Lzw655/kicad_custom_lib/3dmodels/Connector_Others/User Library-TER-KF128-2P.STEP

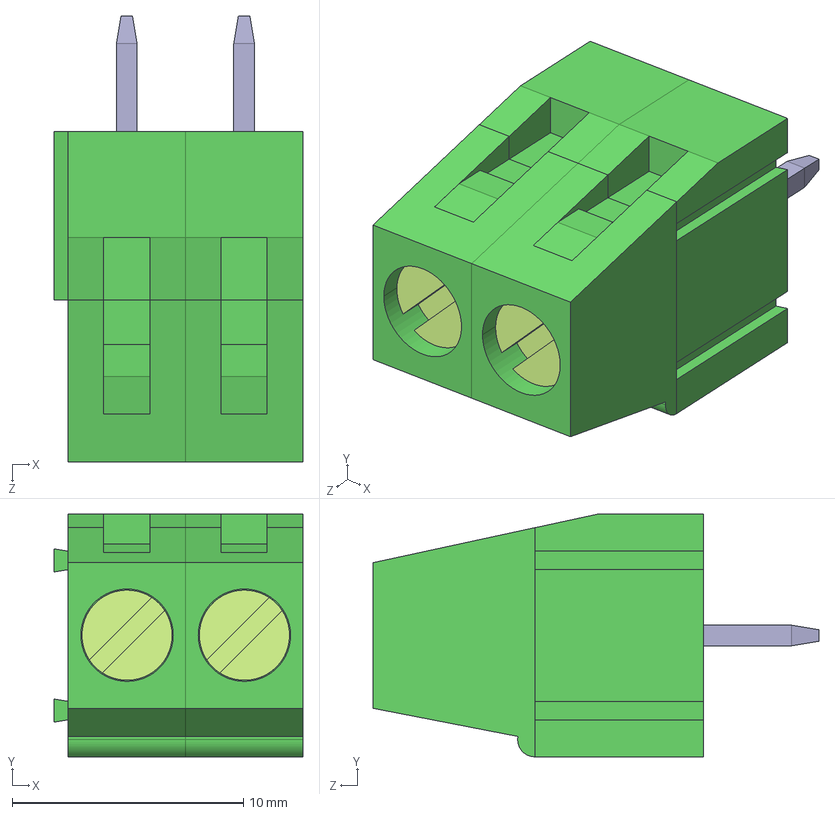
[picture p5: CAD file, 2022-12-03]
3dmodels/Connector_Others/User Library-TER-KF128-2P.STEP
10.8 x 10.5 x 19.3 mm
