Lzw655/kicad_custom_lib/3dmodels/Connector_Power/User Library-A3D-014-00008.STEP

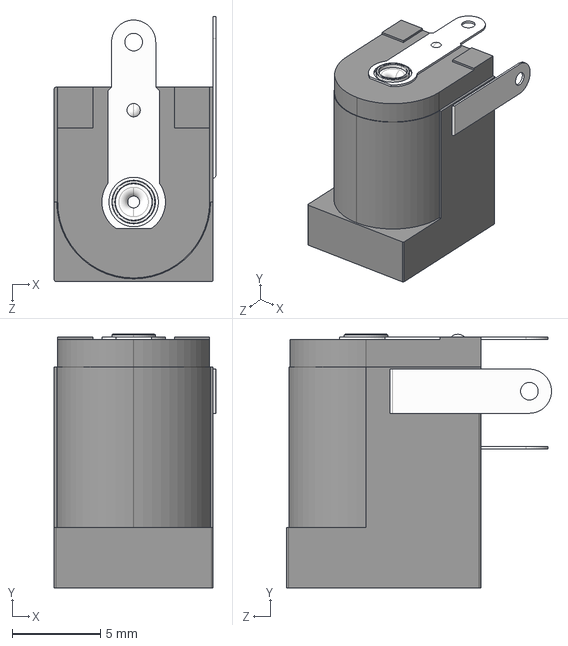
[picture p6: CAD file, 2022-12-03]
3dmodels/Connector_Power/User Library-A3D-014-00008.STEP
9.15 x 14.3 x 15.0 mm
