Lzw655/kicad_custom_lib/3dmodels/Display_7Segment_Module/User Library-IND 3641 RED.STEP

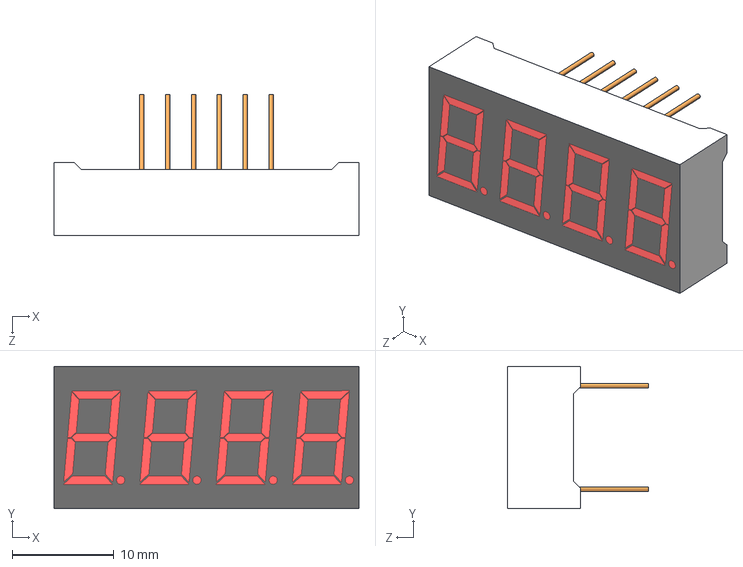
[picture p7: CAD file, 2022-12-03]
3dmodels/Display_7Segment_Module/User Library-IND 3641 RED.STEP
30.0 x 14.0 x 13.9 mm
