Lzw655/kicad_custom_lib/3dmodels/Display_Led_Segment/User Library-10 Segment Bar Graph MultiColor Array.STEP

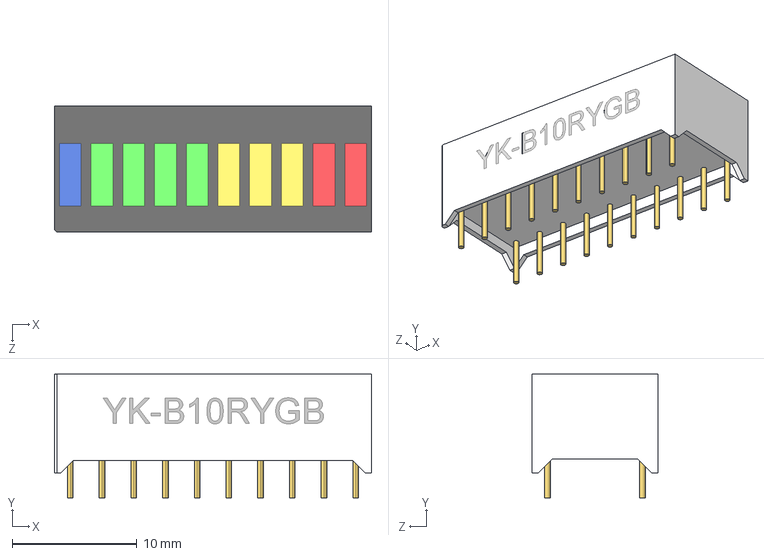
[picture p8: CAD file, 2022-12-03]
3dmodels/Display_Led_Segment/User Library-10 Segment Bar Graph MultiColor Array.STEP
25.4 x 9.92 x 10.1 mm
