Lzw655/kicad_custom_lib/3dmodels/Rotary_Encoder/User Library-EC11E-05SW.STEP

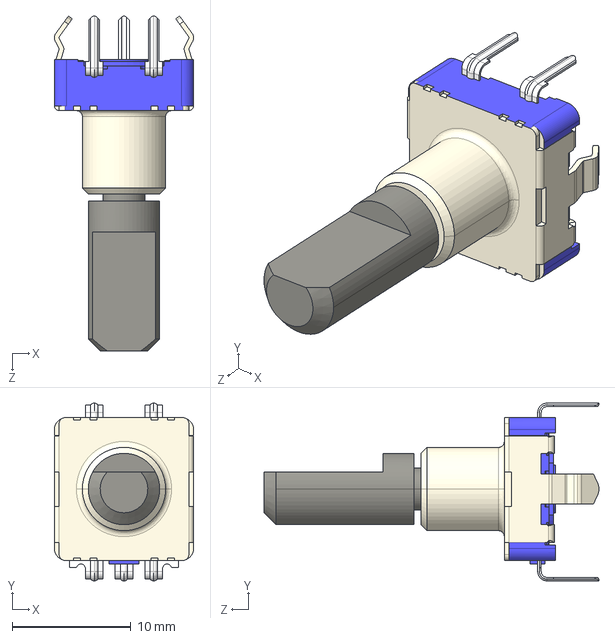
[picture p9: CAD file, 2022-12-03]
3dmodels/Rotary_Encoder/User Library-EC11E-05SW.STEP
11.7 x 15.0 x 28.2 mm
