Lzw655/kicad_custom_lib/3dmodels/Display_7Segment_Module/User Library-C-564 (7 segment 4 digit LED display).STEP

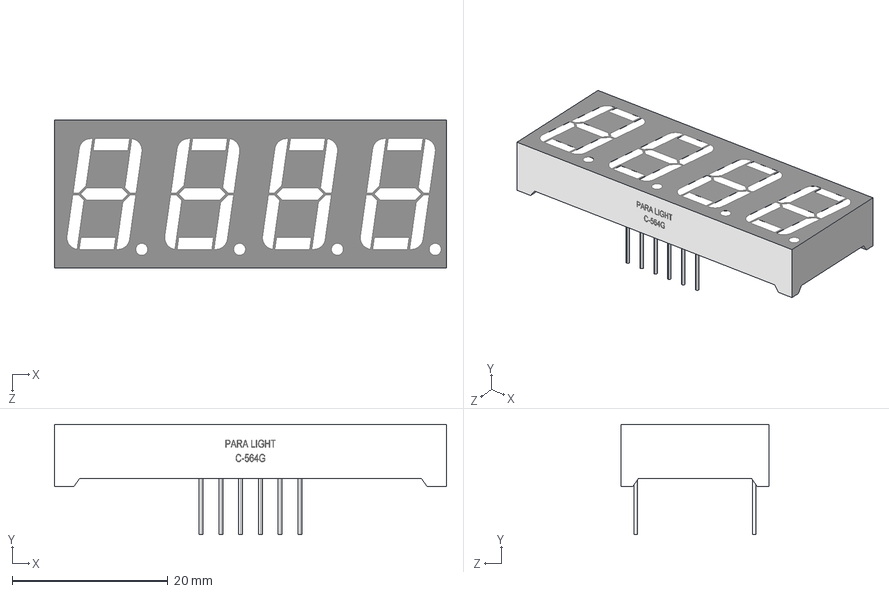
[picture p10: CAD file, 2022-12-03]
3dmodels/Display_7Segment_Module/User Library-C-564 (7 segment 4 digit LED display).STEP
50.4 x 14.2 x 19.0 mm
