Lzw655/kicad_custom_lib/scripting/plugins/Kicad_action_plugins-5_99_test/archive_project/archived_test_project/shapes3D/C_1206_3216Metric.step

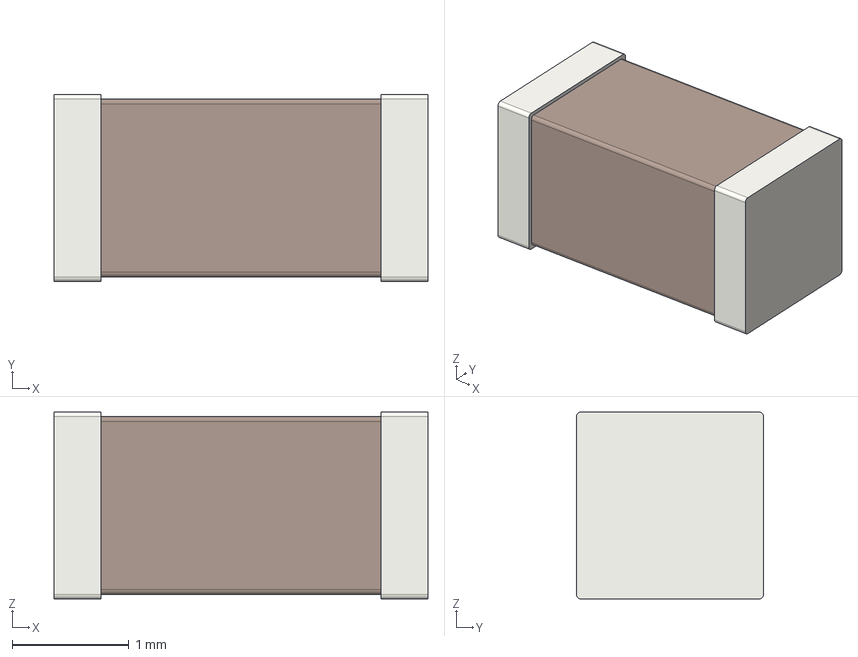
[picture p11: CAD file, 2022-12-03, an earlier design]
scripting/plugins/Kicad_action_plugins-5_99_test/archive_project/archived_test_project/shapes3D/C_1206_3216Metric.step
3.20 x 1.60 x 1.60 mm
