Lzw655/kicad_custom_lib/scripting/plugins/Kicad_action_plugins-5_99_test/archive_project/fresh_test_project/R_1206_3216Metric.step

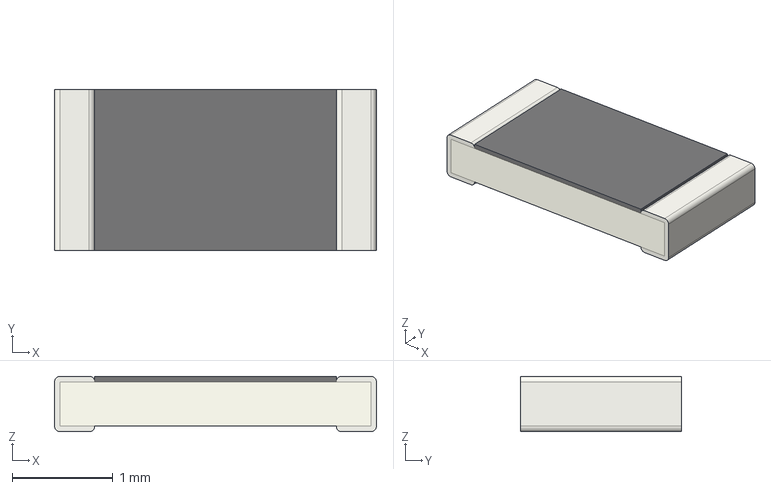
[picture p12: CAD file, 2022-12-03, an earlier design]
scripting/plugins/Kicad_action_plugins-5_99_test/archive_project/fresh_test_project/R_1206_3216Metric.step
3.20 x 1.60 x 0.55 mm
