Lzw655/kicad_custom_lib/scripting/plugins/Kicad_action_plugins-5_99_test/archive_project/fresh_test_project/PhoenixContact_MSTBA_2,5_2-G-5,08_1x02_P5.08mm_Horizontal.step

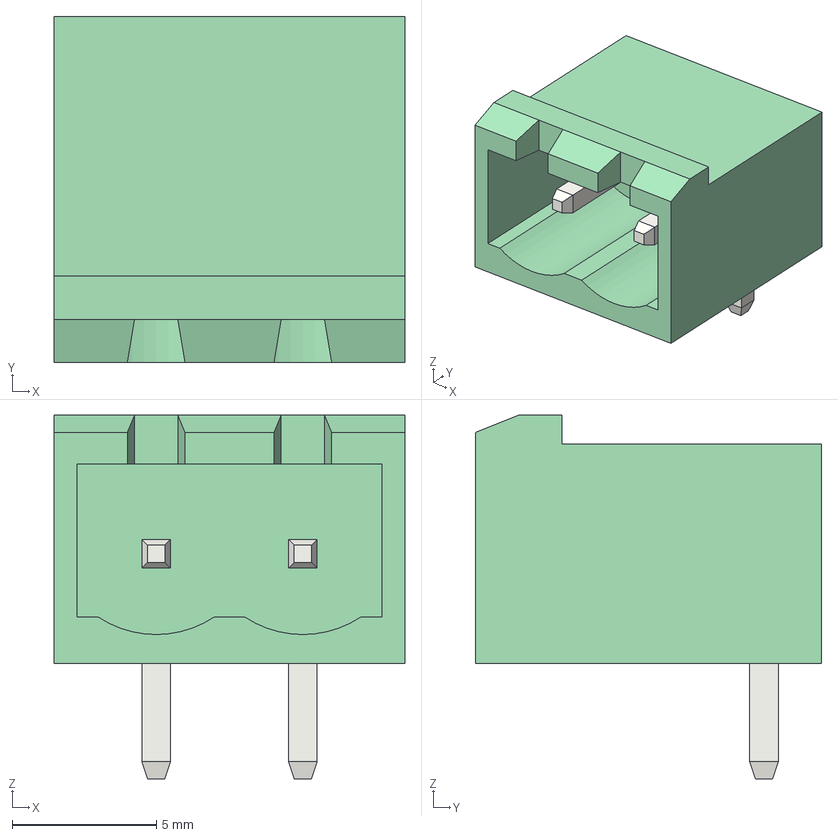
[picture p13: CAD file, 2022-12-03, an earlier design]
scripting/plugins/Kicad_action_plugins-5_99_test/archive_project/fresh_test_project/PhoenixContact_MSTBA_2,5_2-G-5,08_1x02_P5.08mm_Horizontal.step
12.2 x 12.0 x 12.6 mm
