Lzw655/kicad_custom_lib/scripting/plugins/Kicad_action_plugins-5_99_test/archive_project/archived_test_project/shapes3D/DIP-14_W7.62mm.step

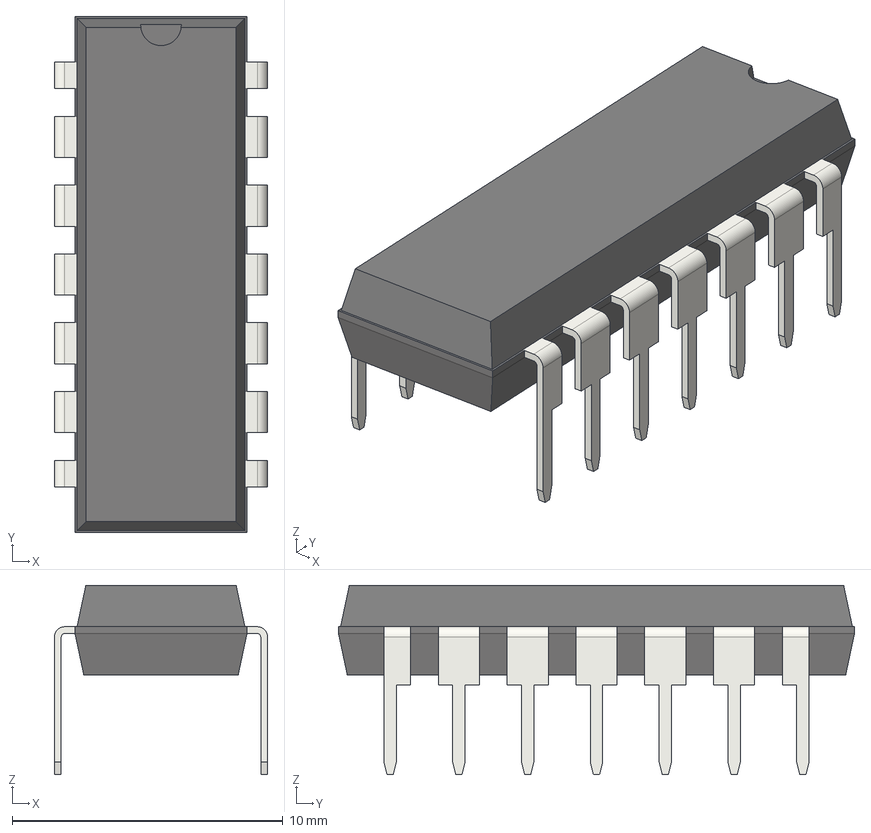
[picture p14: CAD file, 2022-12-03, an earlier design]
scripting/plugins/Kicad_action_plugins-5_99_test/archive_project/archived_test_project/shapes3D/DIP-14_W7.62mm.step
7.87 x 19.1 x 6.98 mm
