Lzw655/kicad_custom_lib/scripting/plugins/Kicad_action_plugins-5_99_test/archive_project/archived_test_project/shapes3D/PinHeader_1x02_P2.54mm_Horizontal.step

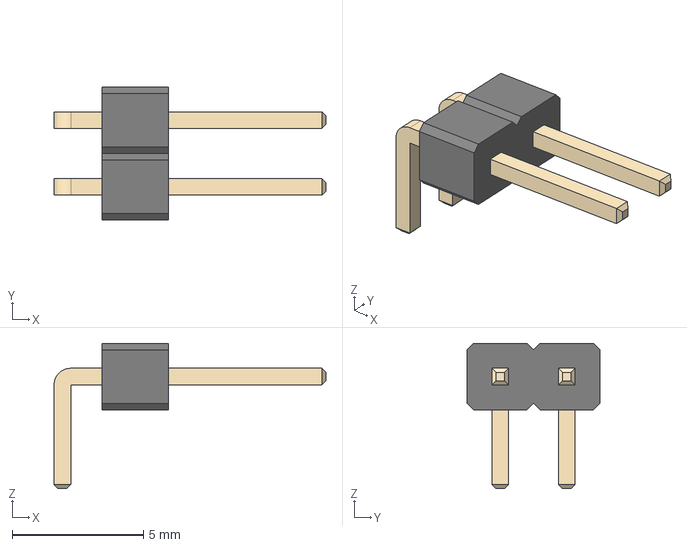
[picture p15: CAD file, 2022-12-03, an earlier design]
scripting/plugins/Kicad_action_plugins-5_99_test/archive_project/archived_test_project/shapes3D/PinHeader_1x02_P2.54mm_Horizontal.step
10.4 x 5.08 x 5.54 mm
