Lzw655/kicad_custom_lib/scripting/plugins/kicad_freerouting-plugin-master/doc/build-options.md

### build options

1. ensure commit

https://git.launchpad.net/kicad/commit/?id=3e4913adce86ea3955b7dac39703425d9cb2c41e

2. configure build

```
Application: kicad
Version: (5.1.0-387-g6993e5c5b), release build
Libraries:
    wxWidgets 3.0.4
    libcurl/7.64.1 OpenSSL/1.1.1b zlib/1.2.11 libidn2/2.1.1 libpsl/0.20.2 (+libidn2/2.1.1) libssh2/1.8.1 nghttp2/1.36.0
Platform: Linux 5.0.10-arch1-1-ARCH x86_64, 64 bit, Little endian, wxGTK
Build Info:
    wxWidgets: 3.0.4 (wchar_t,wx containers,compatible with 2.8) GTK+ 3.24
    Boost: 1.69.0
    OpenCASCADE Technology: 7.3.0
    Curl: 7.64.1
    Compiler: GCC 8.2.1 with C++ ABI 1013

Build settings:
    USE_WX_GRAPHICS_CONTEXT=OFF
    USE_WX_OVERLAY=ON
    KICAD_SCRIPTING=ON
    KICAD_SCRIPTING_MODULES=ON
    KICAD_SCRIPTING_PYTHON3=ON
    KICAD_SCRIPTING_WXPYTHON=ON
    KICAD_SCRIPTING_WXPYTHON_PHOENIX=ON
    KICAD_SCRIPTING_ACTION_MENU=ON
    BUILD_GITHUB_PLUGIN=ON
    KICAD_USE_OCE=OFF
    KICAD_USE_OCC=ON
    KICAD_SPICE=ON
```
