Lzw655/kicad_custom_lib/scripting/plugins/Kicad_action_plugins-5_99_test/archive_project/fresh_test_project/archive_test_project.kicad_pcb

## KiCad design scripting/plugins/Kicad_action_plugins-5_99_test/archive_project/fresh_test_project/archive_test_project.kicad_pcb (2022-12-03, an earlier design)

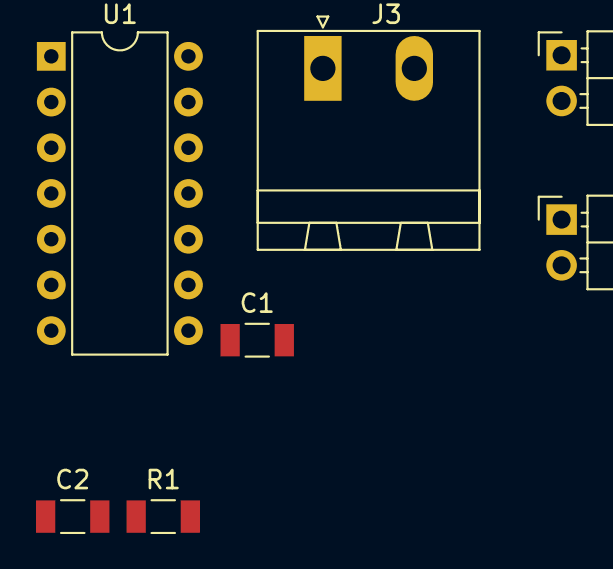
[picture p16: board archive_test_project.kicad_pcb from above]

Board: 2 copper layers, 7 parts (0 on the bottom side), 5 nets, no tracks yet.

Parts:
C1, C2: C; C_1206_3216Metric
J1, J2: Conn_01x02; PinHeader_1x02_P2.54mm_Horizontal
J3: Screw_Terminal_01x02; PhoenixContact_MSTBA_2,5_2-G-5,08_1x02_P5.08mm_Horizontal
R1: R; R_1206_3216Metric
U1: LM318J; DIP-14_W7.62mm

Connections:
+15V: C1.1, J2.2, U1.11
/subsheet/IN: R1.2, U1.4, U1.10
/subsheet/OUT: C2.1, J3.1, R1.1
GND: C1.2, C2.2, J1.1, J2.1, J3.2, U1.6
unnamed: J1.2, U1.5
