Lzw655/kicad_custom_lib/scripting/plugins/Kicad_action_plugins-5_99_test/swap_pins/swap_pins_test.kicad_pcb

## KiCad design scripting/plugins/Kicad_action_plugins-5_99_test/swap_pins/swap_pins_test.kicad_pcb (2022-12-03)

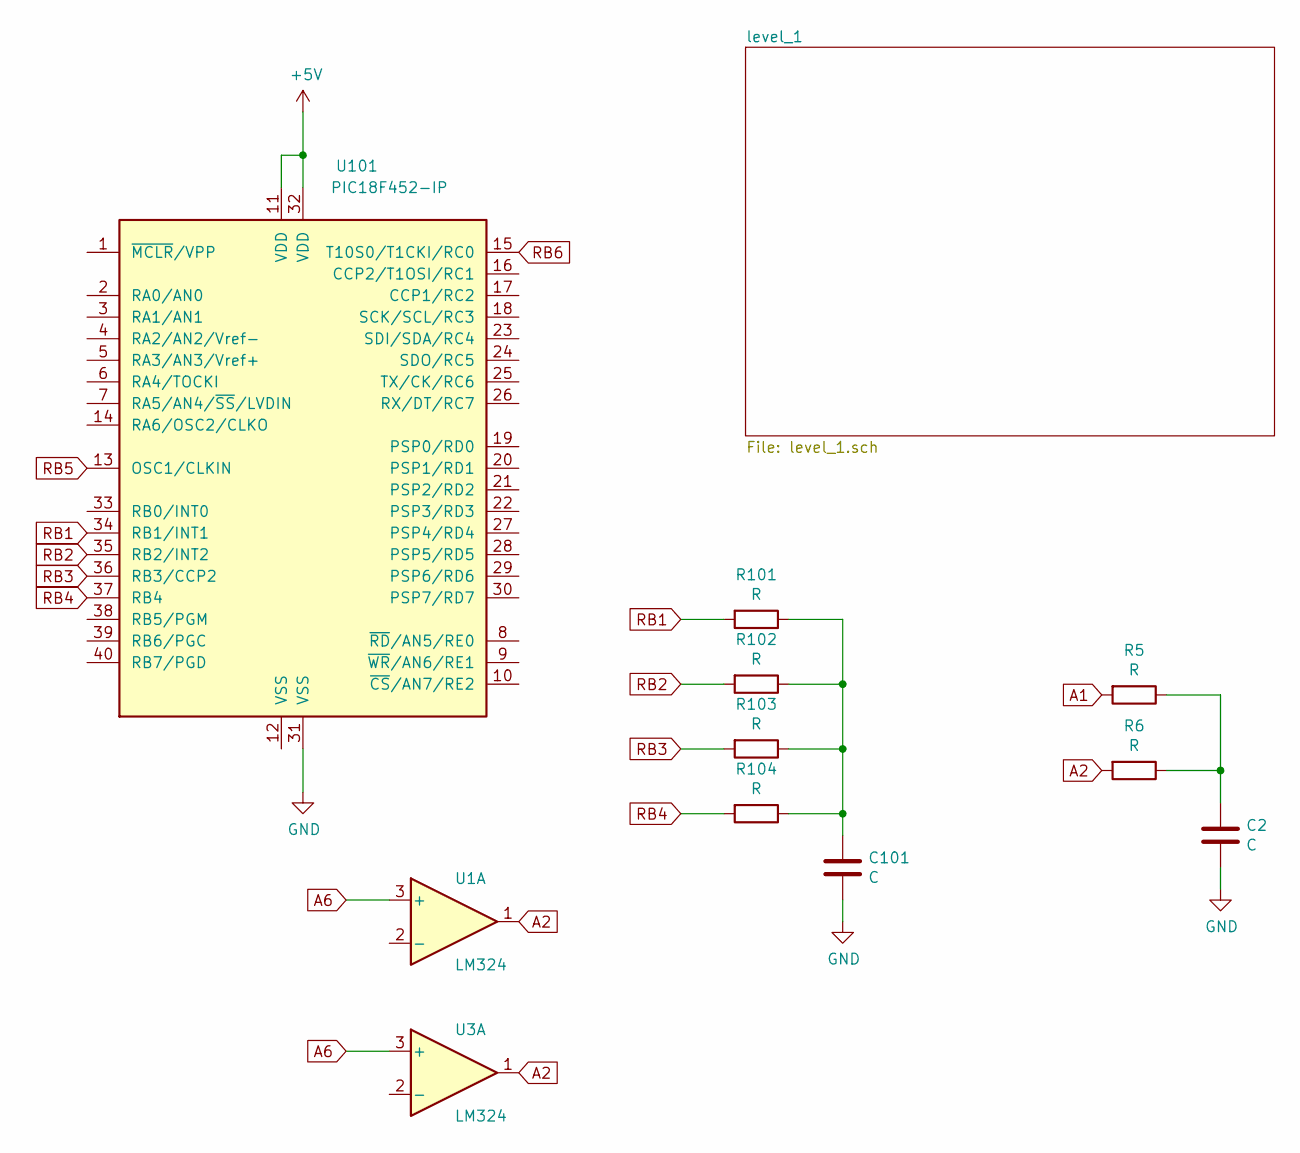
[picture p17: schematic swap_pins_test.sch]

Parts:
C2, C101: C; C_Disc_D7.5mm_W5.0mm_P5.00mm
R5, R6, R101, R102, R103, R104: R; R_Axial_DIN0614_L14.3mm_D5.7mm_P20.32mm_Horizontal
U1, U3: LM324; DIP-14_W7.62mm
U101: PIC18F452-IP; DIP-40_W15.24mm

Connections:
+5V: U101.11 (VDD), U101.32 (VDD); also elsewhere on the board
A1: R5.2; also elsewhere on the board
A2: R6.2, U1.1, U3.1
A6: U1.3 (+), U3.3 (+)
GND: C2.2, C101.2, U101.31 (VSS); also elsewhere on the board
unnamed: C2.1, R5.1, R6.1
unnamed: C101.1, R101.1, R102.1, R103.1, R104.1
RB1: R101.2, U101.34 (RB1/INT1)
RB2: R102.2, U101.35 (RB2/INT2)
RB3: R103.2, U101.36 (RB3/CCP2)
RB4: R104.2, U101.37 (RB4)
RB5: U101.13 (OSC1/CLKIN)
RB6: U101.15 (T10S0/T1CKI/RC0)

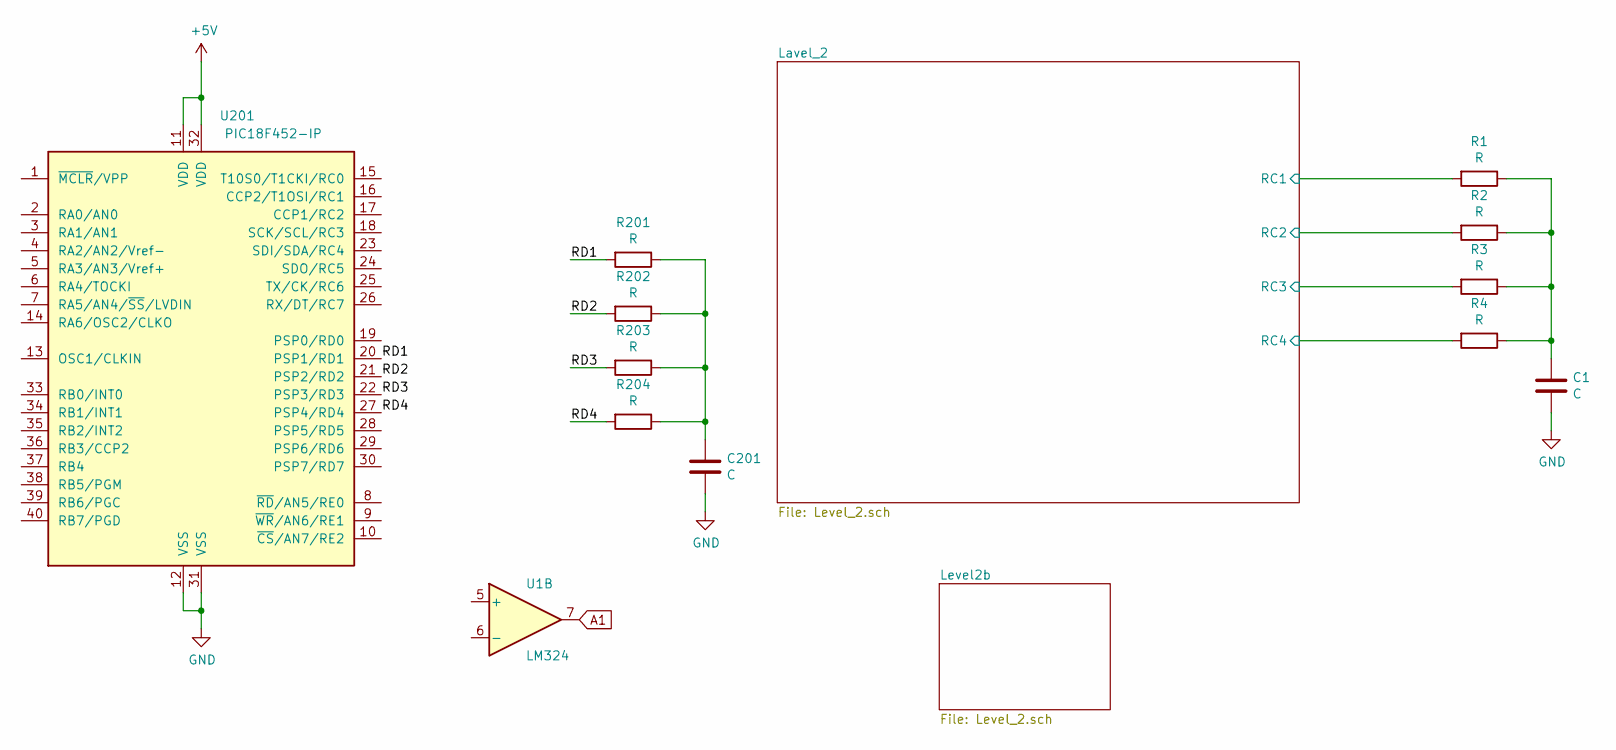
[picture p18: schematic level_1.sch]

Parts:
C1, C201: C; C_Disc_D7.5mm_W5.0mm_P5.00mm
R1, R2, R3, R4, R201, R202, R203, R204: R; R_Axial_DIN0614_L14.3mm_D5.7mm_P20.32mm_Horizontal
U1: LM324
U201: PIC18F452-IP; DIP-40_W15.24mm

Connections:
+5V: U201.11 (VDD), U201.32 (VDD); also elsewhere on the board
/level_1/Lavel_2/RC1: R1.2; also elsewhere on the board
/level_1/Lavel_2/RC2: R2.2; also elsewhere on the board
/level_1/Lavel_2/RC3: R3.2; also elsewhere on the board
/level_1/Lavel_2/RC4: R4.2; also elsewhere on the board
/level_1/RD1: R201.2, U201.20 (PSP1/RD1)
/level_1/RD2: R202.2, U201.21 (PSP2/RD2)
/level_1/RD3: R203.2, U201.22 (PSP3/RD3)
/level_1/RD4: R204.2, U201.27 (PSP4/RD4)
A1: U1.7; also elsewhere on the board
GND: C1.2, C201.2, U201.12 (VSS), U201.31 (VSS); also elsewhere on the board
unnamed: C1.1, R1.1, R2.1, R3.1, R4.1
unnamed: C201.1, R201.1, R202.1, R203.1, R204.1

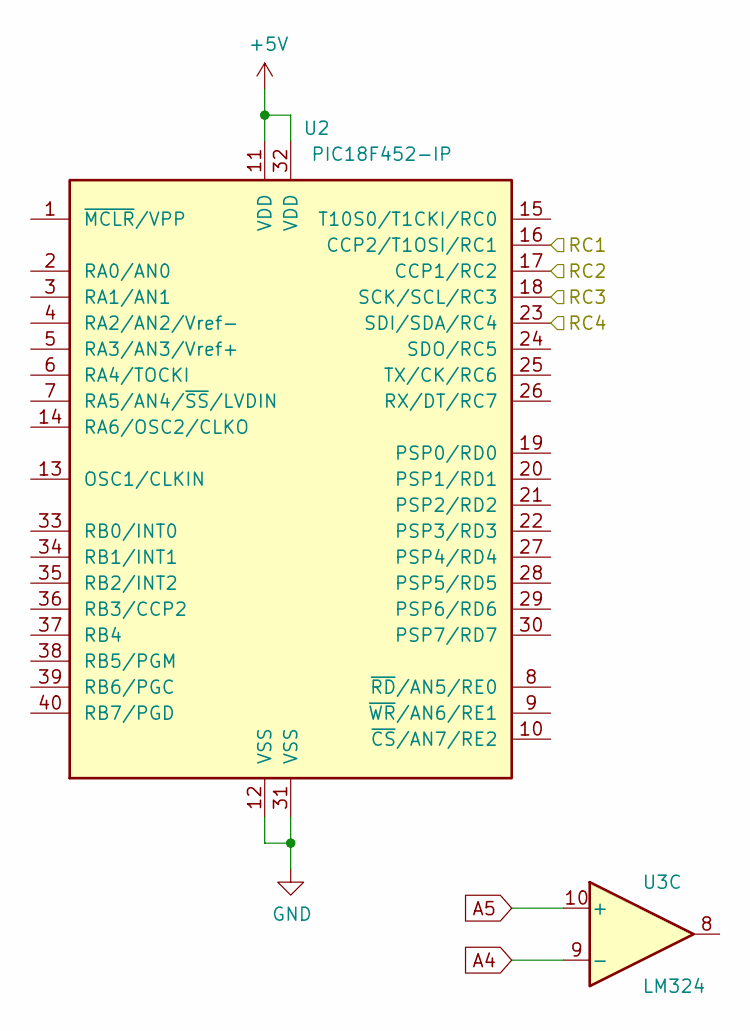
[picture p19: schematic Level_2.sch]

Parts:
U1: LM324
U301: PIC18F452-IP; DIP-40_W15.24mm

Connections:
+5V: U301.11 (VDD), U301.32 (VDD); also elsewhere on the board
/level_1/Lavel_2/RC1: U301.16 (CCP2/T1OSI/RC1); also elsewhere on the board
/level_1/Lavel_2/RC2: U301.17 (CCP1/RC2); also elsewhere on the board
/level_1/Lavel_2/RC3: U301.18 (SCK/SCL/RC3); also elsewhere on the board
/level_1/Lavel_2/RC4: U301.23 (SDI/SDA/RC4); also elsewhere on the board
A4: U1.9 (-); also elsewhere on the board
A5: U1.10 (+); also elsewhere on the board
GND: U301.12 (VSS), U301.31 (VSS); also elsewhere on the board

Parts of its further copies:
U2: PIC18F452-IP; DIP-40_W15.24mm

Connections of its further copies:
+5V: U2.11 (VDD), U2.32 (VDD); also elsewhere on the board
/level_1/Level2b/RC1: U2.16 (CCP2/T1OSI/RC1)
/level_1/Level2b/RC2: U2.17 (CCP1/RC2)
/level_1/Level2b/RC3: U2.18 (SCK/SCL/RC3)
/level_1/Level2b/RC4: U2.23 (SDI/SDA/RC4)
GND: U2.12 (VSS), U2.31 (VSS); also elsewhere on the board

Board: 2 copper layers, 24 parts (0 on the bottom side), 23 nets, no tracks yet.
