Lzw655/kicad_custom_lib/scripting/plugins/Kicad_action_plugins-5_99_test/save_restore_layout/Destination_project/Destination_project.kicad_pcb

## KiCad design scripting/plugins/Kicad_action_plugins-5_99_test/save_restore_layout/Destination_project/Destination_project.kicad_pcb (2022-12-03)

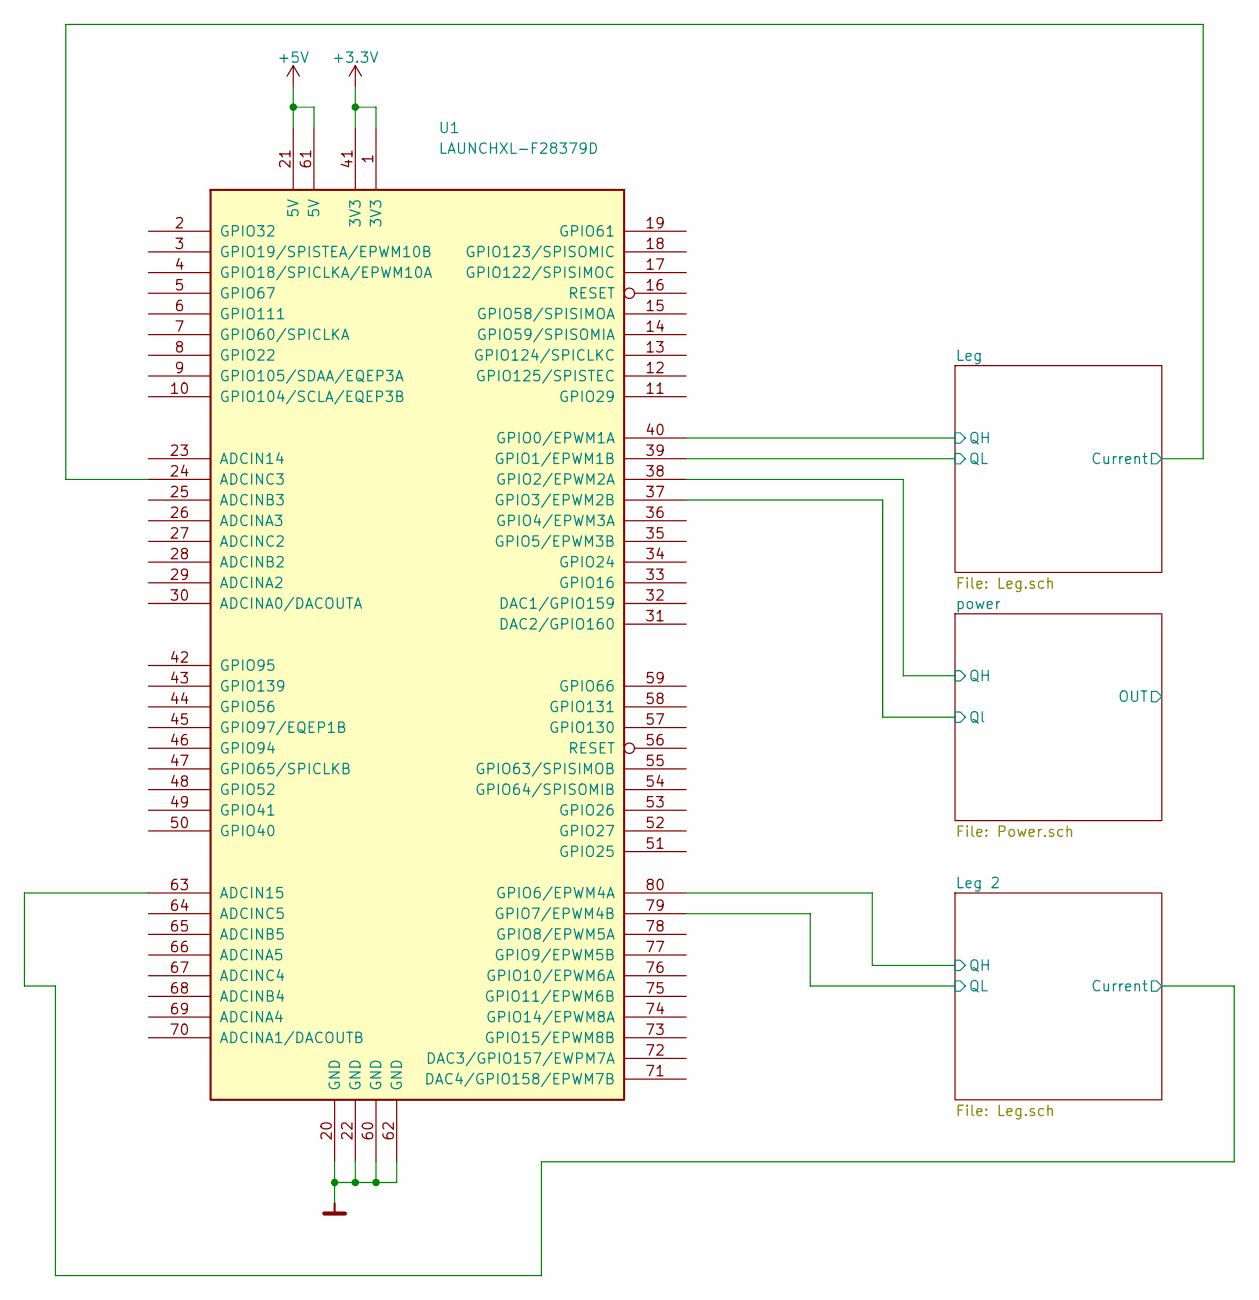
[picture p20: schematic Destination_project.sch]

Parts:
U1: LAUNCHXL-F28379D; 28379D_launchpad

Connections:
+3V3: U1.1 (3V3), U1.41 (3V3); also elsewhere on the board
+5V: U1.21 (5V), U1.61 (5V)
-VDC: U1.20 (GND), U1.22 (GND), U1.60 (GND), U1.62 (GND); also elsewhere on the board
/Leg 2/Current: U1.63 (ADCIN15); also elsewhere on the board
/Leg 2/QH: U1.80 (GPIO6/EPWM4A); also elsewhere on the board
/Leg 2/QL: U1.79 (GPIO7/EPWM4B); also elsewhere on the board
/Leg/Current: U1.24 (ADCINC3); also elsewhere on the board
/Leg/QH: U1.40 (GPIO0/EPWM1A); also elsewhere on the board
/Leg/QL: U1.39 (GPIO1/EPWM1B); also elsewhere on the board
/power/QH: U1.38 (GPIO2/EPWM2A); also elsewhere on the board
/power/Ql: U1.37 (GPIO3/EPWM2B); also elsewhere on the board

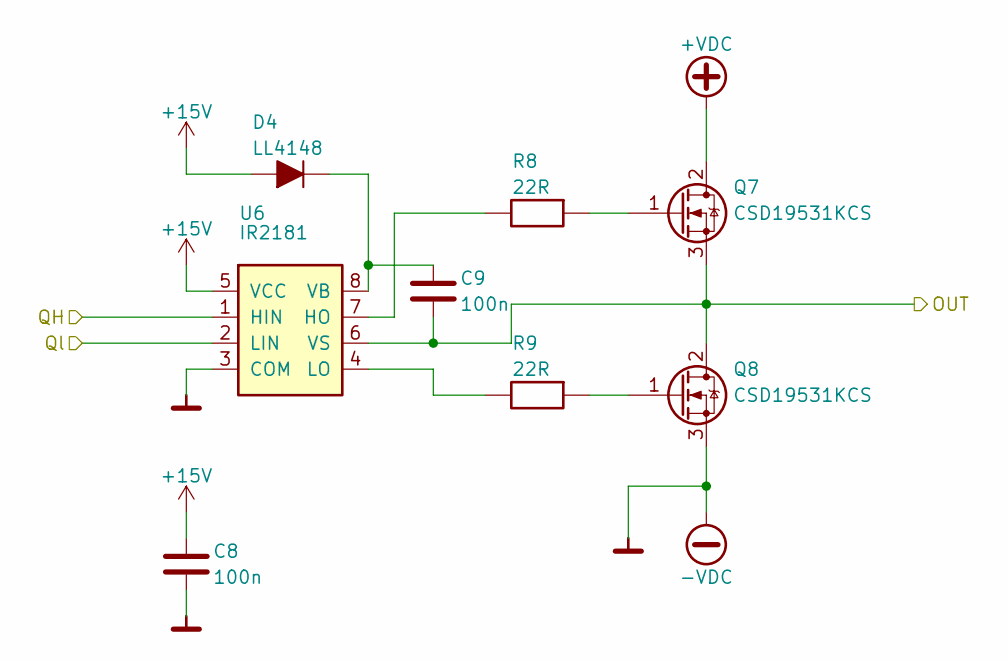
[picture p21: schematic Power.sch]

Parts:
C3, C4: 100n; C1206M
D2: LL4148; D_MiniMELF
Q3, Q4: CSD19531KCS; TO-220
R3, R4: 22R; R1206M
U3: IR2181; SO8

Connections:
+15V: C3.1, D2.2 (A), U3.5 (VCC); also elsewhere on the board
+VDC: Q3.2 (D); also elsewhere on the board
-VDC: C3.2, Q4.3 (S), U3.3 (COM); also elsewhere on the board
/Leg/QH: U3.1 (HIN); also elsewhere on the board
/Leg/QL: U3.2 (LIN); also elsewhere on the board
/Leg/Sensor/IN: C4.2, Q3.3 (S), Q4.2 (D), U3.6 (VS); also elsewhere on the board
unnamed: C4.1, D2.1 (K), U3.8 (VB)
unnamed: Q3.1 (G), R3.2
unnamed: Q4.1 (G), R4.2
unnamed: R3.1, U3.7 (HO)
unnamed: R4.1, U3.4 (LO)

Parts of its further copies:
C1, C2, C6, C7, C8, C9, C11, C12: 100n; C1206M
D1, D3, D4, D5: LL4148; D_MiniMELF
Q1, Q2, Q5, Q6, Q7, Q8, Q9, Q10: CSD19531KCS; TO-220
R1, R2, R6, R7, R8, R9, R11, R12: 22R; R1206M
U2, U5, U6, U8: IR2181; SO8

Connections of its further copies:
+15V: C1.1, C6.1, C8.1, C11.1, D1.2 (A), D3.2 (A), D4.2 (A), D5.2 (A), U2.5 (VCC), U5.5 (VCC), U6.5 (VCC), U8.5 (VCC); also elsewhere on the board
+VDC: Q1.2 (D), Q5.2 (D), Q7.2 (D), Q9.2 (D); also elsewhere on the board
-VDC: C1.2, C6.2, C8.2, C11.2, Q2.3 (S), Q6.3 (S), Q8.3 (S), Q10.3 (S), U2.3 (COM), U5.3 (COM), U6.3 (COM), U8.3 (COM); also elsewhere on the board
/Leg 2/Power-/OUT: C12.2, Q9.3 (S), Q10.2 (D), U8.6 (VS); also elsewhere on the board
/Leg 2/QH: U6.1 (HIN), U8.2 (LIN); also elsewhere on the board
/Leg 2/QL: U6.2 (LIN), U8.1 (HIN); also elsewhere on the board
/Leg 2/Sensor/IN: C9.2, Q7.3 (S), Q8.2 (D), U6.6 (VS); also elsewhere on the board
/Leg/Power-/OUT: C7.2, Q5.3 (S), Q6.2 (D), U5.6 (VS); also elsewhere on the board
/Leg/QH: U5.2 (LIN); also elsewhere on the board
/Leg/QL: U5.1 (HIN); also elsewhere on the board
/power/OUT: C2.2, Q1.3 (S), Q2.2 (D), U2.6 (VS)
/power/QH: U2.1 (HIN); also elsewhere on the board
/power/Ql: U2.2 (LIN); also elsewhere on the board
unnamed: C2.1, D1.1 (K), U2.8 (VB)
unnamed: C7.1, D3.1 (K), U5.8 (VB)
unnamed: C9.1, D4.1 (K), U6.8 (VB)
unnamed: C12.1, D5.1 (K), U8.8 (VB)
unnamed: Q1.1 (G), R1.2
unnamed: Q2.1 (G), R2.2
unnamed: Q5.1 (G), R6.2
unnamed: Q6.1 (G), R7.2
unnamed: Q7.1 (G), R8.2
unnamed: Q8.1 (G), R9.2
unnamed: Q9.1 (G), R11.2
unnamed: Q10.1 (G), R12.2
unnamed: R1.1, U2.7 (HO)
unnamed: R2.1, U2.4 (LO)
unnamed: R6.1, U5.7 (HO)
unnamed: R7.1, U5.4 (LO)
unnamed: R8.1, U6.7 (HO)
unnamed: R9.1, U6.4 (LO)
unnamed: R11.1, U8.7 (HO)
unnamed: R12.1, U8.4 (LO)

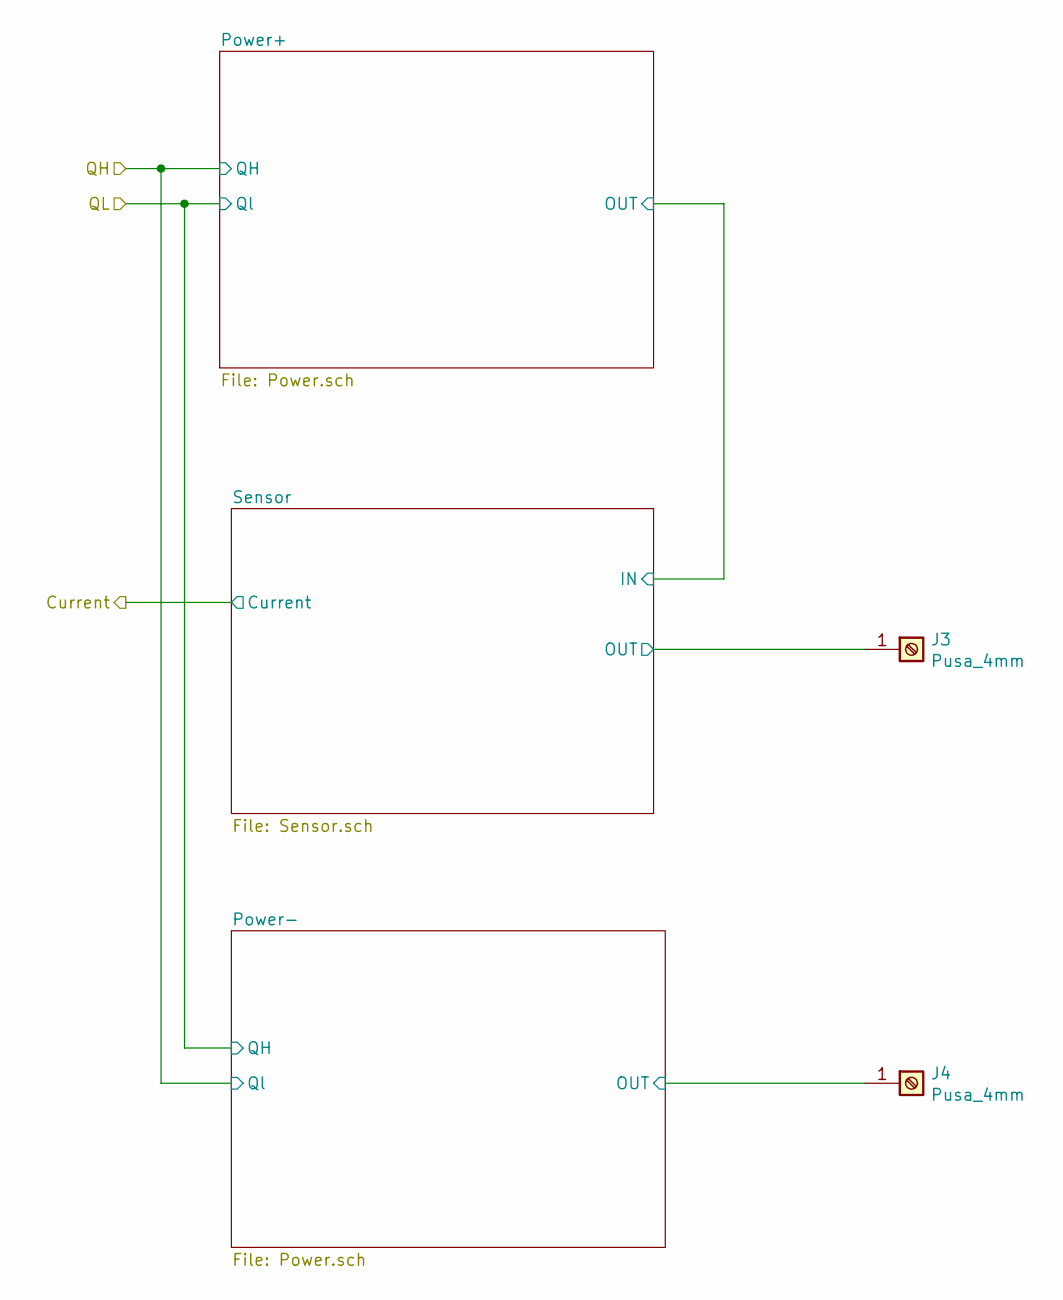
[picture p22: schematic Leg.sch]

Parts:
J1, J2: Pusa_4mm

Connections:
/Leg/Power-/OUT: J2.1; also elsewhere on the board
/Leg/Sensor/OUT: J1.1; also elsewhere on the board

Parts of its further copies:
J3, J4: Pusa_4mm

Connections of its further copies:
/Leg 2/Power-/OUT: J4.1; also elsewhere on the board
/Leg 2/Sensor/OUT: J3.1; also elsewhere on the board

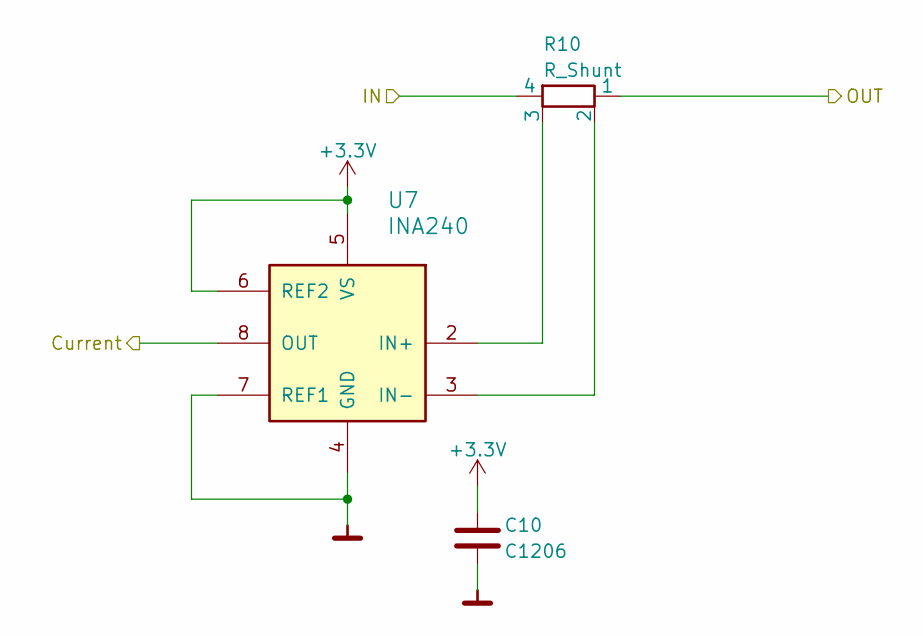
[picture p23: schematic Sensor.sch]

Parts:
C5: C1206; C1206M
R5: R_Shunt; RM
U4: INA240; TSSOP-8_4.4x3mm_P0.65mm

Connections:
+3V3: C5.1, U4.5 (VS), U4.6 (REF2); also elsewhere on the board
-VDC: C5.2, U4.4 (GND), U4.7 (REF1); also elsewhere on the board
/Leg/Current: U4.8 (OUT); also elsewhere on the board
/Leg/Sensor/IN: R5.4; also elsewhere on the board
/Leg/Sensor/OUT: R5.1; also elsewhere on the board
unnamed: R5.2, U4.3 (IN-)
unnamed: R5.3, U4.2 (IN+)

Parts of its further copies:
C10: C1206; C1206M
R10: R_Shunt; RM
U7: INA240; TSSOP-8_4.4x3mm_P0.65mm

Connections of its further copies:
+3V3: C10.1, U7.5 (VS), U7.6 (REF2); also elsewhere on the board
-VDC: C10.2, U7.4 (GND), U7.7 (REF1); also elsewhere on the board
/Leg 2/Current: U7.8 (OUT); also elsewhere on the board
/Leg 2/Sensor/IN: R10.4; also elsewhere on the board
/Leg 2/Sensor/OUT: R10.1; also elsewhere on the board
unnamed: R10.2, U7.3 (IN-)
unnamed: R10.3, U7.2 (IN+)

Board: 2 copper layers, 51 parts (0 on the bottom side), 49 nets, no tracks yet.
