Lzw655/kicad_custom_lib/scripting/plugins/Kicad_action_plugins-5_99_test/swap_units/swap_units_test_project_same_sheet/swap_units_test.kicad_pcb

## KiCad design scripting/plugins/Kicad_action_plugins-5_99_test/swap_units/swap_units_test_project_same_sheet/swap_units_test.kicad_pcb (2022-12-03)

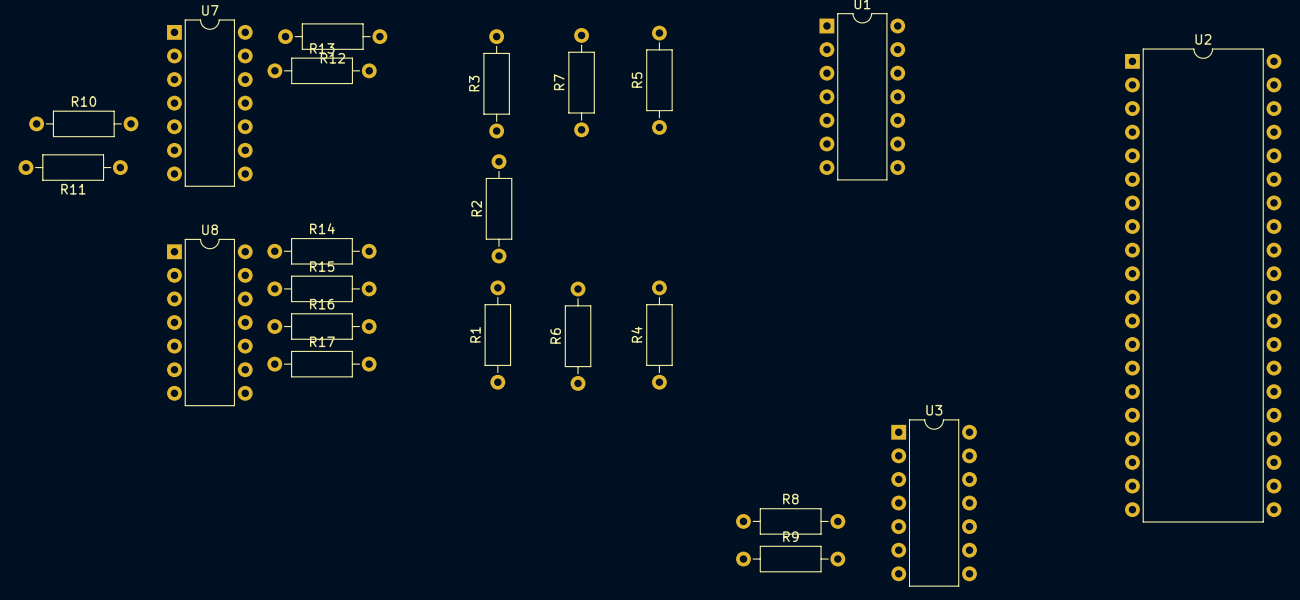
[picture p24: board swap_units_test.kicad_pcb from above]

Board: 2 copper layers, 22 parts (0 on the bottom side), 20 nets, no tracks yet.

Parts:
R1, R2, R3, R4, R5, R6, R7, R8, R9, R10, R11, R12, R13, R14, R15, R16, R17: R; R_Axial_DIN0207_L6.3mm_D2.5mm_P10.16mm_Horizontal
U1, U3, U7, U8: LM324; DIP-14_W7.62mm
U2: PIC18F452-IP; DIP-40_W15.24mm

Connections:
+5V: R1.1, R4.1, R6.1, R8.1, R10.1, R12.1, R14.1, R16.1, U1.4, U2.11, U2.32
/Level1/Level2b/out_level_2: U3.13, U3.14
/Level1/Level3a/out_level_1: U7.13, U7.14
/Level1/Level3a/out_level_2: U7.6, U7.7
/Level1/Level3b/out_level_1: U8.13, U8.14
/Level1/Level3b/out_level_2: U8.6, U8.7
/Level1/out_level_1: U1.8, U1.9, U2.2
/Level1/out_level_2: U1.13, U1.14, U2.3
GND: R3.2, R5.2, R7.2, R9.2, R11.2, R13.2, R15.2, R17.2, U1.11, U2.12, U2.31
unnamed: R1.2, R2.1, U1.5
unnamed: R2.2, R3.1, U1.3
unnamed: R4.2, R5.1, U1.10
unnamed: R6.2, R7.1, U1.12
unnamed: R8.2, R9.1, U3.12
unnamed: R10.2, R11.1, U7.5
unnamed: R12.2, R13.1, U7.12
unnamed: R14.2, R15.1, U8.5
unnamed: R16.2, R17.1, U8.12
unnamed: U1.6, U1.7, U2.4
unnamed: U1.1, U1.2, U2.5
