Lzw655/kicad_custom_lib/scripting/plugins/Kicad_action_plugins-5_99_test/save_restore_layout/Source_project/multiple_hierarchy.kicad_pcb

## KiCad design scripting/plugins/Kicad_action_plugins-5_99_test/save_restore_layout/Source_project/multiple_hierarchy.kicad_pcb (2022-12-03)

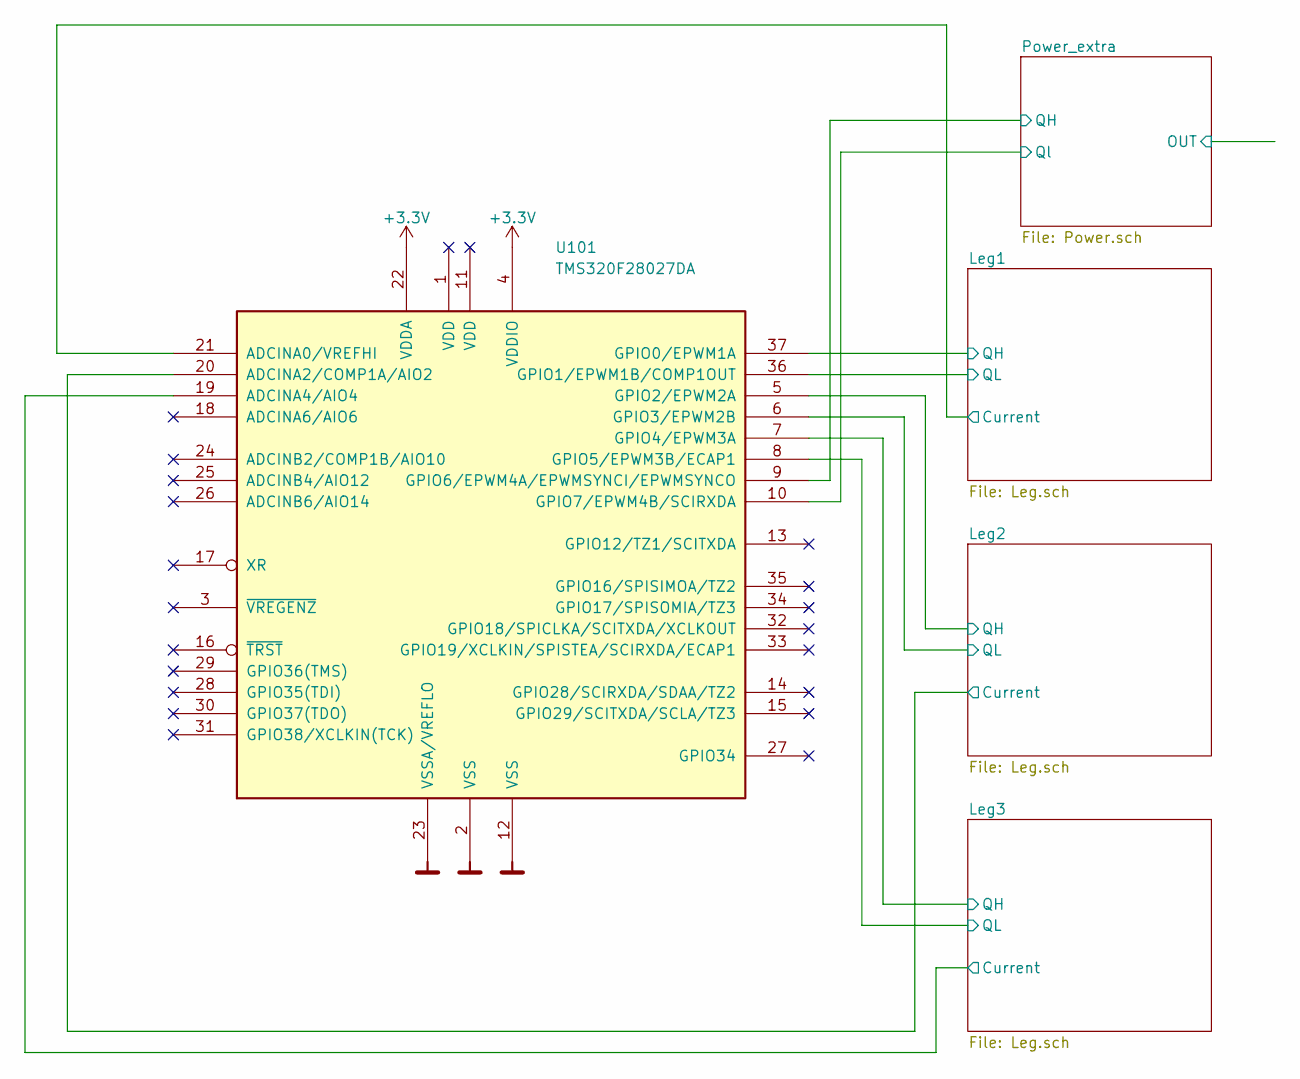
[picture p25: schematic multiple_hierarchy.sch]

Parts:
U101: TMS320F28027DA; TSSOP-38_4.4x9.7mm_P0.5mm

Connections:
+3V3: U101.4 (VDDIO), U101.22 (VDDA); also elsewhere on the board
-VDC: U101.2 (VSS), U101.12 (VSS), U101.23 (VSSA/VREFLO); also elsewhere on the board
/Leg1/Current: U101.21 (ADCINA0/VREFHI); also elsewhere on the board
/Leg1/QH: U101.37 (GPIO0/EPWM1A); also elsewhere on the board
/Leg1/QL: U101.36 (GPIO1/EPWM1B/COMP1OUT); also elsewhere on the board
/Leg2/Current: U101.20 (ADCINA2/COMP1A/AIO2); also elsewhere on the board
/Leg2/QH: U101.5 (GPIO2/EPWM2A); also elsewhere on the board
/Leg2/QL: U101.6 (GPIO3/EPWM2B); also elsewhere on the board
/Leg3/Current: U101.19 (ADCINA4/AIO4); also elsewhere on the board
/Leg3/QH: U101.7 (GPIO4/EPWM3A); also elsewhere on the board
/Leg3/QL: U101.8 (GPIO5/EPWM3B/ECAP1); also elsewhere on the board
/Power_extra/QH: U101.9 (GPIO6/EPWM4A/EPWMSYNCI/EPWMSYNCO); also elsewhere on the board
/Power_extra/Ql: U101.10 (GPIO7/EPWM4B/SCIRXDA); also elsewhere on the board

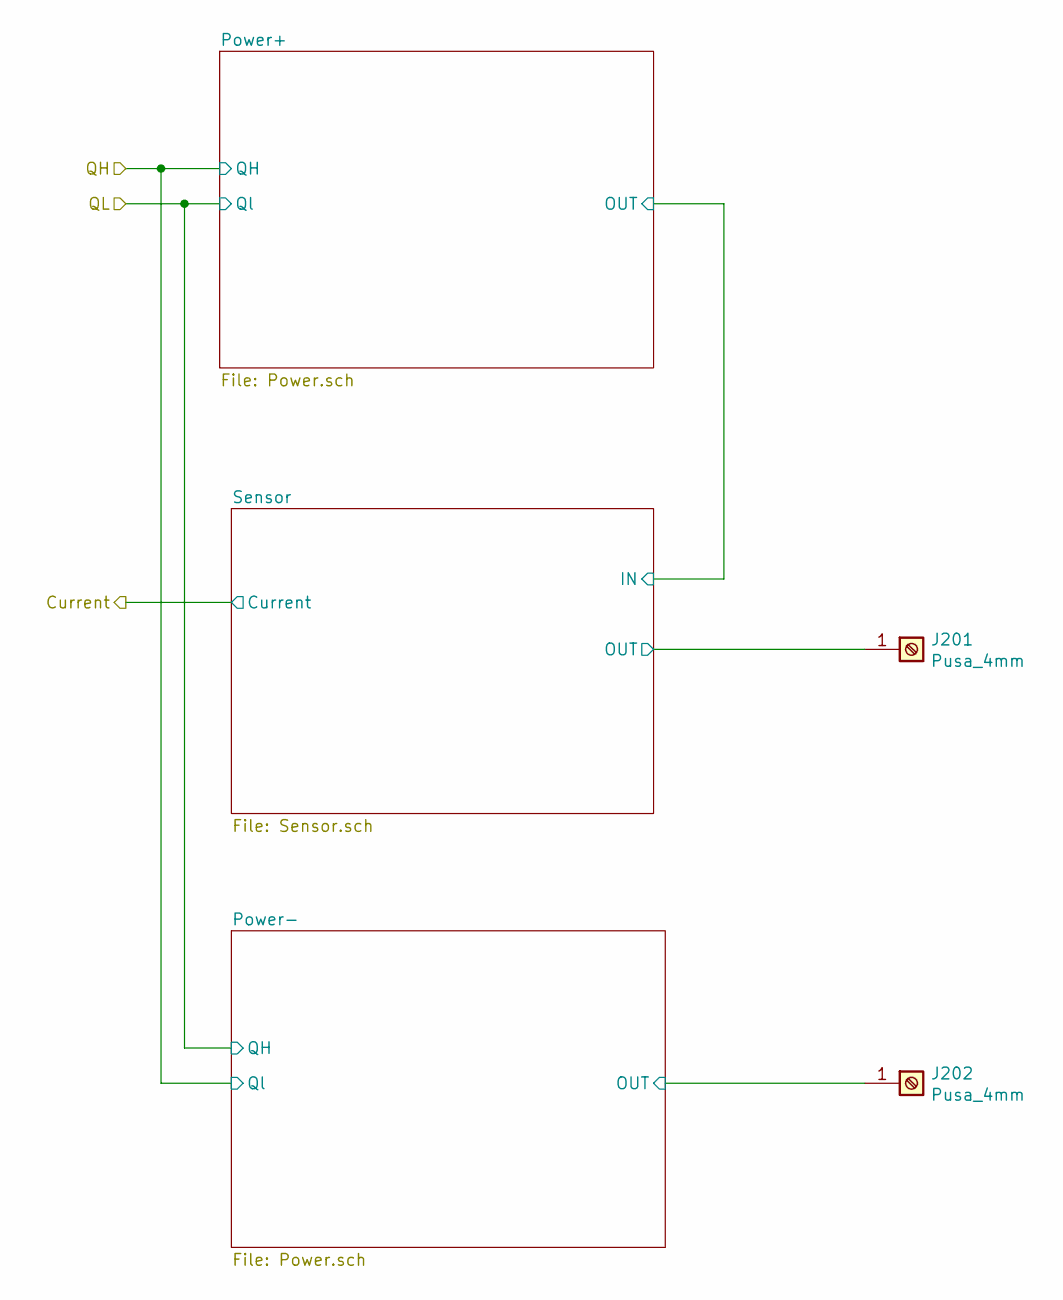
[picture p26: schematic Leg.sch]

Parts:
J201, J202: Pusa_4mm

Connections:
/Leg1/Power-/OUT: J202.1; also elsewhere on the board
/Leg1/Sensor/OUT: J201.1; also elsewhere on the board

Parts of its further copies:
J601, J602, J1001, J1002: Pusa_4mm

Connections of its further copies:
/Leg2/Power-/OUT: J602.1; also elsewhere on the board
/Leg2/Sensor/OUT: J601.1; also elsewhere on the board
/Leg3/Power-/OUT: J1002.1; also elsewhere on the board
/Leg3/Sensor/OUT: J1001.1; also elsewhere on the board

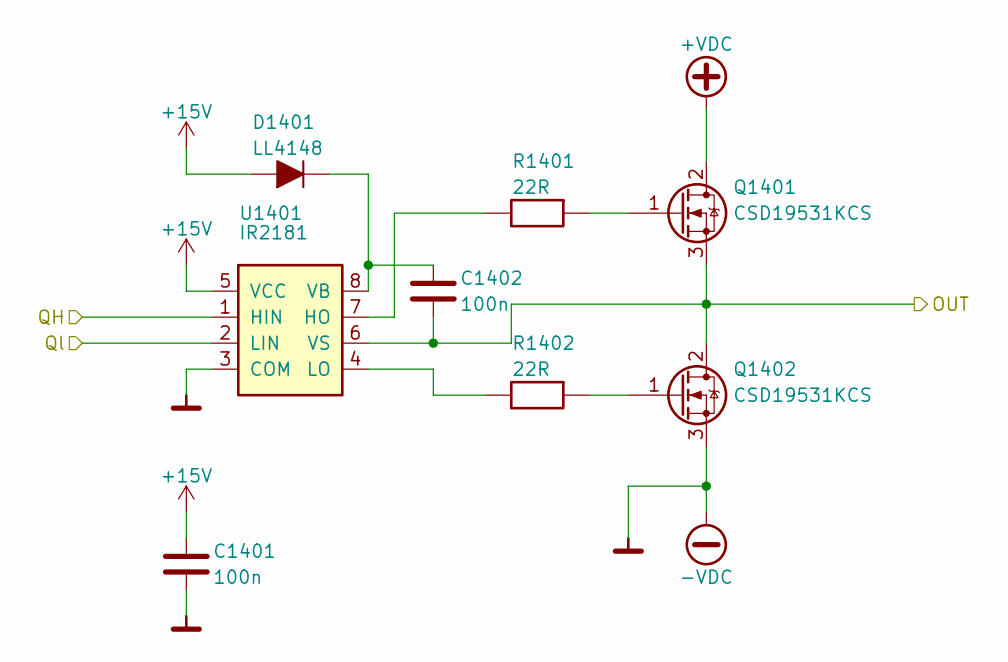
[picture p27: schematic Power.sch]

Parts:
C301, C302: 100n; C1206M
D301: LL4148; D_MiniMELF
Q301, Q302: CSD19531KCS; TO-220
R301, R302: 22R; R1206M
U301: IR2181; SO8

Connections:
+15V: C301.1, D301.2 (A), U301.5 (VCC); also elsewhere on the board
+VDC: Q301.2 (D); also elsewhere on the board
-VDC: C301.2, Q302.3 (S), U301.3 (COM); also elsewhere on the board
/Leg1/QH: U301.1 (HIN); also elsewhere on the board
/Leg1/QL: U301.2 (LIN); also elsewhere on the board
/Leg1/Sensor/IN: C302.2, Q301.3 (S), Q302.2 (D), U301.6 (VS); also elsewhere on the board
unnamed: C302.1, D301.1 (K), U301.8 (VB)
unnamed: Q301.1 (G), R301.2
unnamed: Q302.1 (G), R302.2
unnamed: R301.1, U301.7 (HO)
unnamed: R302.1, U301.4 (LO)

Parts of its further copies:
C501, C502, C701, C702, C901, C902, C1101, C1102, C1301, C1302, C1401, C1402: 100n; C1206M
D501, D701, D901, D1101, D1301, D1401: LL4148; D_MiniMELF
Q501, Q502, Q701, Q702, Q901, Q902, Q1101, Q1102, Q1301, Q1302, Q1401, Q1402: CSD19531KCS; TO-220
R501, R502, R701, R702, R901, R902, R1101, R1102, R1301, R1302, R1401, R1402: 22R; R1206M
U501, U701, U901, U1101, U1301, U1401: IR2181; SO8

Connections of its further copies:
+15V: C501.1, C701.1, C901.1, C1101.1, C1301.1, C1401.1, D501.2 (A), D701.2 (A), D901.2 (A), D1101.2 (A), D1301.2 (A), D1401.2 (A), U501.5 (VCC), U701.5 (VCC), U901.5 (VCC), U1101.5 (VCC), U1301.5 (VCC), U1401.5 (VCC); also elsewhere on the board
+VDC: Q501.2 (D), Q701.2 (D), Q901.2 (D), Q1101.2 (D), Q1301.2 (D), Q1401.2 (D); also elsewhere on the board
-VDC: C501.2, C701.2, C901.2, C1101.2, C1301.2, C1401.2, Q502.3 (S), Q702.3 (S), Q902.3 (S), Q1102.3 (S), Q1302.3 (S), Q1402.3 (S), U501.3 (COM), U701.3 (COM), U901.3 (COM), U1101.3 (COM), U1301.3 (COM), U1401.3 (COM); also elsewhere on the board
/Leg1/Power-/OUT: C502.2, Q501.3 (S), Q502.2 (D), U501.6 (VS); also elsewhere on the board
/Leg1/QH: U501.2 (LIN); also elsewhere on the board
/Leg1/QL: U501.1 (HIN); also elsewhere on the board
/Leg2/Power-/OUT: C902.2, Q901.3 (S), Q902.2 (D), U901.6 (VS); also elsewhere on the board
/Leg2/QH: U701.1 (HIN), U901.2 (LIN); also elsewhere on the board
/Leg2/QL: U701.2 (LIN), U901.1 (HIN); also elsewhere on the board
/Leg2/Sensor/IN: C702.2, Q701.3 (S), Q702.2 (D), U701.6 (VS); also elsewhere on the board
/Leg3/Power-/OUT: C1302.2, Q1301.3 (S), Q1302.2 (D), U1301.6 (VS); also elsewhere on the board
/Leg3/QH: U1101.1 (HIN), U1301.2 (LIN); also elsewhere on the board
/Leg3/QL: U1101.2 (LIN), U1301.1 (HIN); also elsewhere on the board
/Leg3/Sensor/IN: C1102.2, Q1101.3 (S), Q1102.2 (D), U1101.6 (VS); also elsewhere on the board
/Power_extra/OUT: C1402.2, Q1401.3 (S), Q1402.2 (D), U1401.6 (VS)
/Power_extra/QH: U1401.1 (HIN); also elsewhere on the board
/Power_extra/Ql: U1401.2 (LIN); also elsewhere on the board
unnamed: C502.1, D501.1 (K), U501.8 (VB)
unnamed: C702.1, D701.1 (K), U701.8 (VB)
unnamed: C902.1, D901.1 (K), U901.8 (VB)
unnamed: C1102.1, D1101.1 (K), U1101.8 (VB)
unnamed: C1302.1, D1301.1 (K), U1301.8 (VB)
unnamed: C1402.1, D1401.1 (K), U1401.8 (VB)
unnamed: Q501.1 (G), R501.2
unnamed: Q502.1 (G), R502.2
unnamed: Q701.1 (G), R701.2
unnamed: Q702.1 (G), R702.2
unnamed: Q901.1 (G), R901.2
unnamed: Q902.1 (G), R902.2
unnamed: Q1101.1 (G), R1101.2
unnamed: Q1102.1 (G), R1102.2
unnamed: Q1301.1 (G), R1301.2
unnamed: Q1302.1 (G), R1302.2
unnamed: Q1401.1 (G), R1401.2
unnamed: Q1402.1 (G), R1402.2
unnamed: R501.1, U501.7 (HO)
unnamed: R502.1, U501.4 (LO)
unnamed: R701.1, U701.7 (HO)
unnamed: R702.1, U701.4 (LO)
unnamed: R901.1, U901.7 (HO)
unnamed: R902.1, U901.4 (LO)
unnamed: R1101.1, U1101.7 (HO)
unnamed: R1102.1, U1101.4 (LO)
unnamed: R1301.1, U1301.7 (HO)
unnamed: R1302.1, U1301.4 (LO)
unnamed: R1401.1, U1401.7 (HO)
unnamed: R1402.1, U1401.4 (LO)

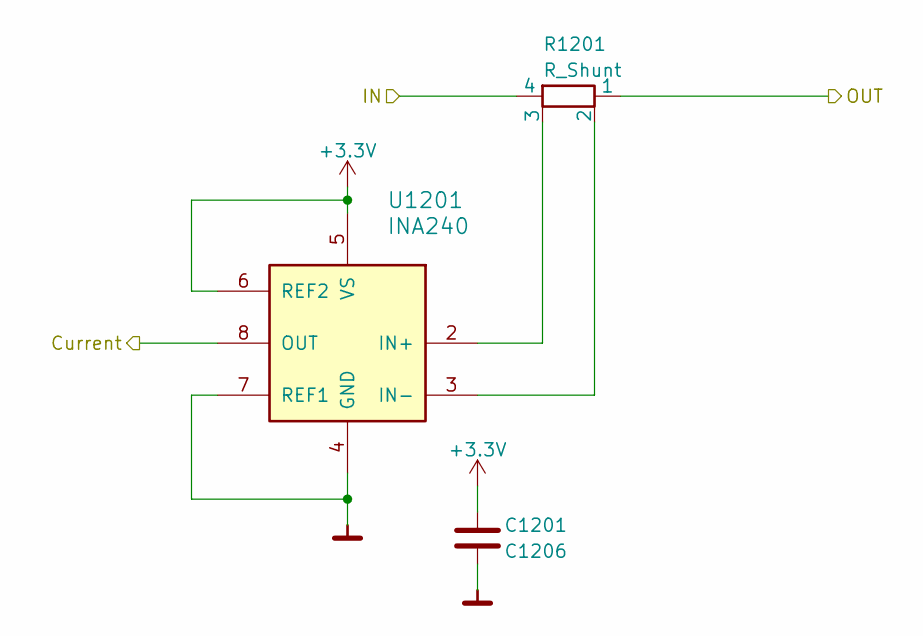
[picture p28: schematic Sensor.sch]

Parts:
C401: C1206; C1206M
R401: R_Shunt; RM
U401: INA240; TSSOP-8_4.4x3mm_P0.65mm

Connections:
+3V3: C401.1, U401.5 (VS), U401.6 (REF2); also elsewhere on the board
-VDC: C401.2, U401.4 (GND), U401.7 (REF1); also elsewhere on the board
/Leg1/Current: U401.8 (OUT); also elsewhere on the board
/Leg1/Sensor/IN: R401.4; also elsewhere on the board
/Leg1/Sensor/OUT: R401.1; also elsewhere on the board
unnamed: R401.2, U401.3 (IN-)
unnamed: R401.3, U401.2 (IN+)

Parts of its further copies:
C801, C1201: C1206; C1206M
R801, R1201: R_Shunt; RM
U801, U1201: INA240; TSSOP-8_4.4x3mm_P0.65mm

Connections of its further copies:
+3V3: C801.1, C1201.1, U801.5 (VS), U801.6 (REF2), U1201.5 (VS), U1201.6 (REF2); also elsewhere on the board
-VDC: C801.2, C1201.2, U801.4 (GND), U801.7 (REF1), U1201.4 (GND), U1201.7 (REF1); also elsewhere on the board
/Leg2/Current: U801.8 (OUT); also elsewhere on the board
/Leg2/Sensor/IN: R801.4; also elsewhere on the board
/Leg2/Sensor/OUT: R801.1; also elsewhere on the board
/Leg3/Current: U1201.8 (OUT); also elsewhere on the board
/Leg3/Sensor/IN: R1201.4; also elsewhere on the board
/Leg3/Sensor/OUT: R1201.1; also elsewhere on the board
unnamed: R801.2, U801.3 (IN-)
unnamed: R801.3, U801.2 (IN+)
unnamed: R1201.2, U1201.3 (IN-)
unnamed: R1201.3, U1201.2 (IN+)
