Lzw655/kicad_custom_lib/scripting/plugins/Kicad_action_plugins-5_99_test/save_restore_layout/Source_project/multiple_hierarchy.kicad_pcb

## KiCad design scripting/plugins/Kicad_action_plugins-5_99_test/save_restore_layout/Source_project/multiple_hierarchy.kicad_pcb (continued)

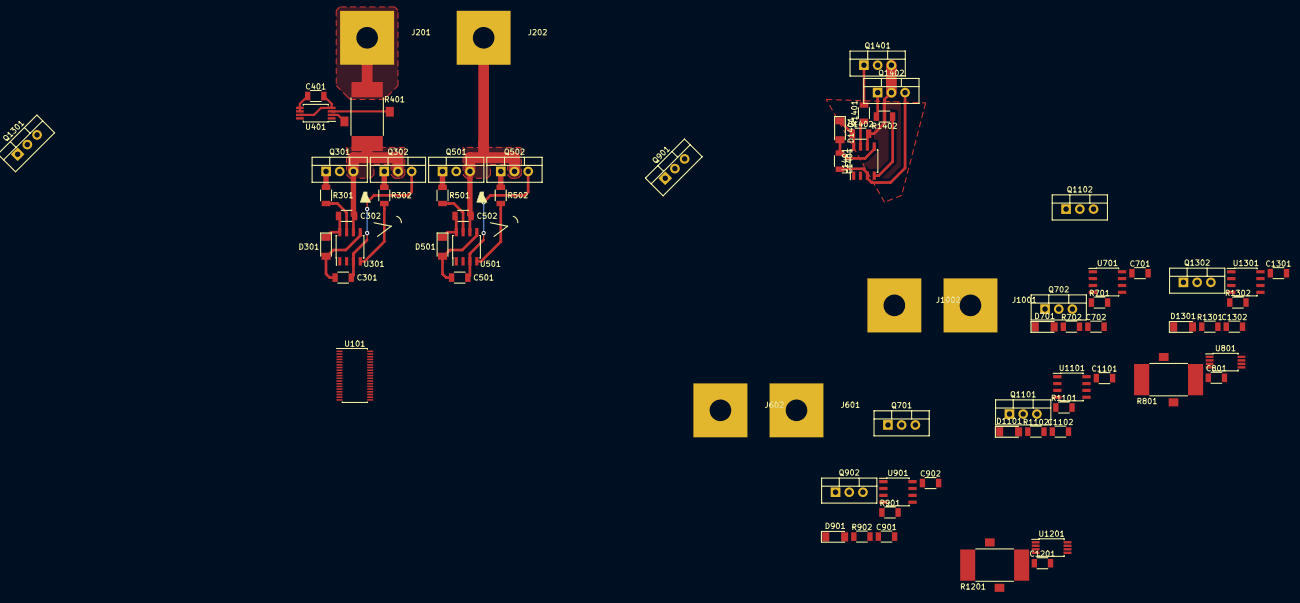
[picture p29: board multiple_hierarchy.kicad_pcb from above]

Board: 2 copper layers, 72 parts (0 on the bottom side), 66 nets.
