Lzw655/kicad_custom_lib/scripting/plugins/Kicad_action_plugins-5_99_test/pad2pad_track_distance/En_mostic_test.kicad_pcb

## KiCad design scripting/plugins/Kicad_action_plugins-5_99_test/pad2pad_track_distance/En_mostic_test.kicad_pcb (2022-12-03)

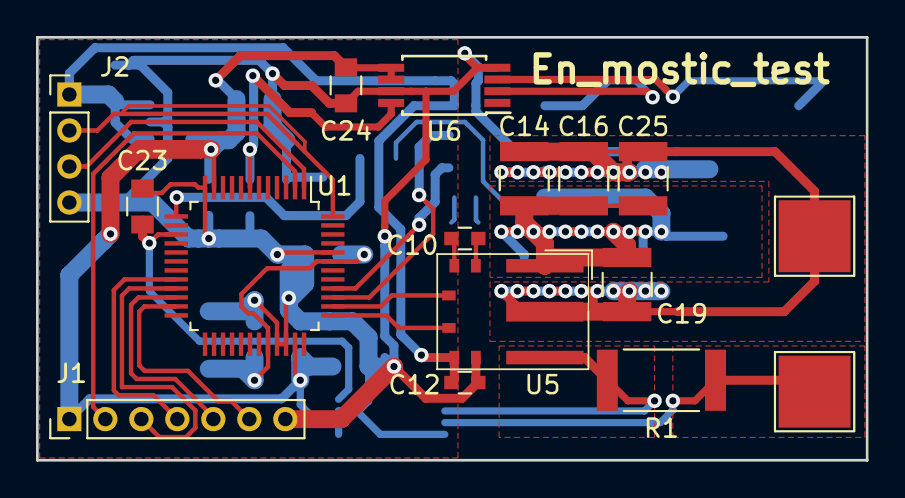
[picture p30: board En_mostic_test.kicad_pcb from above]

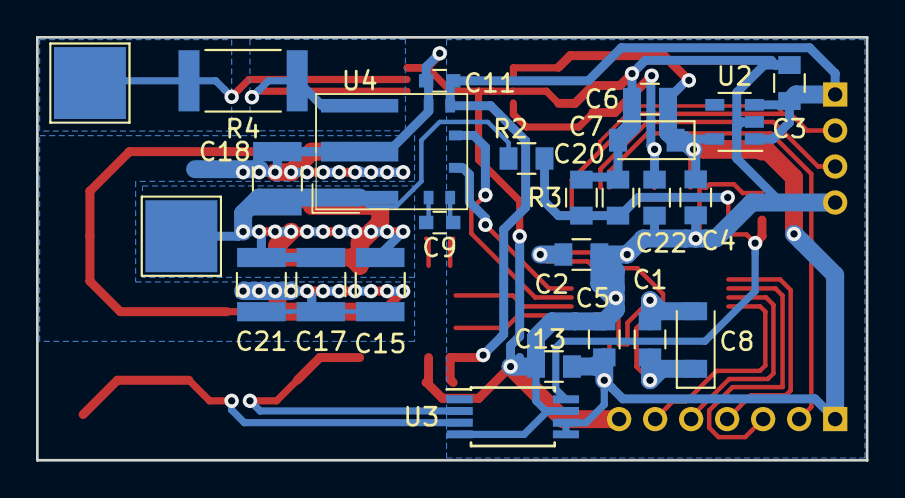
[picture p31: board En_mostic_test.kicad_pcb from below]

Board: 2 copper layers, 46.1 x 23.5 mm, 41 parts (25 on the bottom side), 27 nets.

Parts:
C1, C2, C3, C4, C5, C6, C13, C20, C24: 100nF; C0805M
C7, C8: 2u2; CT_A
C9, C10, C11, C12: 100nF; C0603M
C14, C15, C16, C17, C18, C19, C21, C25: 4u7; C_1210_3225Metric
C22, C23: 50pF; C0805M
J1: JTAG; PinHeader_1x07_P2.00mm_Vertical
J2: SCI; PinHeader_1x04_P2.00mm_Vertical
J3: M+; TestPoint_Pad_4.0x4.0mm
J4: M-; TestPoint_Pad_4.0x4.0mm
J5: DC+; TestPoint_Pad_4.0x4.0mm
J6: DC-; TestPoint_Pad_4.0x4.0mm
R1, R4: R; R_2512_6332Metric
R2: 100k; R0805M
R3: 10k; R0805M
U1: TMS320F28027PT; LQFP-48_7x7mm_P0.5mm
U2: TPS76333; SOT-23-5
U3, U6: INA240; TSSOP-8_4.4x3mm_P0.65mm
U4, U5: LMG5200; QFM(MOF)

Connections:
+1V8: C1.1, C2.1, C8.1, U1.32, U1.43
+3V3: C4.1, C5.1, C6.1, C7.1, C13.1, C24.1, J1.1, U1.11, U1.35, U2.5, U3.5, U3.6, U6.5, U6.6
+5V: C3.1, C11.1, C12.1, J2.1, U2.1, U2.3, U4.6, U5.6
+VDC: C14.1, C15.1, C16.1, C17.1, C18.1, C19.1, C21.1, C25.1, J5.1, R2.1, U4.1, U5.1
-VDC: C1.2, C2.2, C3.2, C4.2, C5.2, C6.2, C7.2, C8.2, C11.2, C12.2, C13.2, C14.2, C15.2, C16.2, C17.2, C18.2, C19.2, C20.2, C21.2, C22.2, C23.2, C24.2, C25.2, J1.7, J2.4, J6.1, R3.2, U1.12, U1.33, U1.34, U1.44, U2.2, U3.4, U3.7, U4.7, U4.9, U5.7, U5.9, U6.4, U6.7
/M+: J3.1, R4.1, U6.3
/M-: J4.1, R1.1, U3.3
/NAP: C20.1, R2.2, R3.1, U1.13
/Q1: U1.40, U4.4
/Q2: U1.39, U4.5
/Q3: U1.38, U5.4
/Q4: U1.37, U5.5
/TOK+: C22.1, U1.7, U6.8
/TOK-: C23.1, U1.15, U3.8
unnamed: C9.1, U4.2
unnamed: C9.2, U4.3
unnamed: C10.1, U5.2
unnamed: C10.2, U5.3
unnamed: J1.2, U1.2
unnamed: J1.3, U1.21
unnamed: J1.4, U1.20
unnamed: J1.5, U1.22
unnamed: J1.6, U1.23
unnamed: J2.2, U1.48
unnamed: J2.3, U1.1
unnamed: R1.2, U3.2, U5.8
unnamed: R4.2, U4.8, U6.2
