Lzw655/kicad_custom_lib/scripting/plugins/InteractiveHtmlBom-master/InteractiveHtmlBom/core/newstroke_font.py

"""
 * newstroke_font.cpp - definitions for automatically converted font
 *
 * This program source code file is part of KiCad, a free EDA CAD application.
 *
 * Copyright (C) 2010 vladimir uryvaev <vovanius@bk.ru>
 * Copyright (C) 1992-2010 KiCad Developers, see change_log.txt for contributors.
 *
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
#include <newstroke_font.h>

This file is copied from KiCad source tree and
slightly modified to be valid python by qu1ck.
"""

NEWSTROKE_FONT = [
    # /* // BASIC LATIN (0020-007F) */
    "JZ", # /* U+20 SPACE  */
    "MWRYSZR[QZRYR[ RRSQGRFSGRSRF",
    "JZNFNJ RVFVJ",
    "H]LM[M RRDL_ RYVJV RS_YD",
    "H\\LZO[T[VZWYXWXUWSVRTQPPNOMNLLLJMHNGPFUFXG RRCR^",
    "F^J[ZF RMFOGPIOKMLKKJIKGMF RYZZXYVWUUVTXUZW[YZ",
    "E_[[Z[XZUWPQNNMKMINGPFQFSGTITJSLRMLQKRJTJWKYLZN[Q[SZTYWUXRXP",
    "MWSFQJ",
    "KYVcUbS_R]QZPUPQQLRISGUDVC",
    "KYNcObQ_R]SZTUTQSLRIQGODNC",
    "JZRFRK RMIRKWI ROORKUO",
    "E_JSZS RR[RK",
    "MWSZS[R]Q^",
    "E_JSZS",
    "MWRYSZR[QZRYR[",
    "G][EI`",
    "H\\QFSFUGVHWJXNXSWWVYUZS[Q[OZNYMWLSLNMJNHOGQF", # /* U+30 DIGIT_0  */
    "H\\X[L[ RR[RFPINKLL",
    "H\\LHMGOFTFVGWHXJXLWOK[X[",
    "H\\KFXFQNTNVOWPXRXWWYVZT[N[LZKY",
    "H\\VMV[ RQELTYT",
    "H\\WFMFLPMOONTNVOWPXRXWWYVZT[O[MZLY",
    "H\\VFRFPGOHMKLOLWMYNZP[T[VZWYXWXRWPVOTNPNNOMPLR",
    "H\\KFYFP[",
    "H\\PONNMMLKLJMHNGPFTFVGWHXJXKWMVNTOPONPMQLSLWMYNZP[T[VZWYXWXSWQVPTO",
    "H\\N[R[TZUYWVXRXJWHVGTFPFNGMHLJLOMQNRPSTSVRWQXO",
    "MWRYSZR[QZRYR[ RRNSORPQORNRP",
    "MWSZS[R]Q^ RRNSORPQORNRP",
    "E_ZMJSZY",
    "E_JPZP RZVJV",
    "E_JMZSJY",
    "I[QYRZQ[PZQYQ[ RMGOFTFVGWIWKVMUNSORPQRQS",
    "D_VQUPSOQOOPNQMSMUNWOXQYSYUXVW RVOVWWXXXZW[U[PYMVKRJNKKMIPHTIXK[N]R^V]Y[", # /* U+40 AT  */
    "I[MUWU RK[RFY[",
    "G\\SPVQWRXTXWWYVZT[L[LFSFUGVHWJWLVNUOSPLP",
    "F[WYVZS[Q[NZLXKVJRJOKKLINGQFSFVGWH",
    "G\\L[LFQFTGVIWKXOXRWVVXTZQ[L[",
    "H[MPTP RW[M[MFWF",
    "HZTPMP RM[MFWF",
    "F[VGTFQFNGLIKKJOJRKVLXNZQ[S[VZWYWRSR",
    "G]L[LF RLPXP RX[XF",
    "MWR[RF",
    "JZUFUUTXRZO[M[",
    "G\\L[LF RX[OO RXFLR",
    "HYW[M[MF",
    "F^K[KFRUYFY[",
    "G]L[LFX[XF",
    "G]PFTFVGXIYMYTXXVZT[P[NZLXKTKMLINGPF",
    "G\\L[LFTFVGWHXJXMWOVPTQLQ", # /* U+50 P_CAP  */
    "G]Z]X\\VZSWQVOV RP[NZLXKTKMLINGPFTFVGXIYMYTXXVZT[P[",
    "G\\X[QQ RL[LFTFVGWHXJXMWOVPTQLQ",
    "H\\LZO[T[VZWYXWXUWSVRTQPPNOMNLLLJMHNGPFUFXG",
    "JZLFXF RR[RF",
    "G]LFLWMYNZP[T[VZWYXWXF",
    "I[KFR[YF",
    "F^IFN[RLV[[F",
    "H\\KFY[ RYFK[",
    "I[RQR[ RKFRQYF",
    "H\\KFYFK[Y[",
    "KYVbQbQDVD",
    "KYID[_",
    "KYNbSbSDND",
    "LXNHREVH",
    "JZJ]Z]",
    "NVPESH", # /* U+60 GRAVE  */
    "I\\W[WPVNTMPMNN RWZU[P[NZMXMVNTPSUSWR",
    "H[M[MF RMNOMSMUNVOWQWWVYUZS[O[MZ",
    "HZVZT[P[NZMYLWLQMONNPMTMVN",
    "I\\W[WF RWZU[Q[OZNYMWMQNOONQMUMWN",
    "I[VZT[P[NZMXMPNNPMTMVNWPWRMT",
    "MYOMWM RR[RISGUFWF",
    "I\\WMW^V`UaSbPbNa RWZU[Q[OZNYMWMQNOONQMUMWN",
    "H[M[MF RV[VPUNSMPMNNMO",
    "MWR[RM RRFQGRHSGRFRH",
    "MWRMR_QaObNb RRFQGRHSGRFRH",
    "IZN[NF RPSV[ RVMNU",
    "MXU[SZRXRF",
    "D`I[IM RIOJNLMOMQNRPR[ RRPSNUMXMZN[P[[",
    "I\\NMN[ RNOONQMTMVNWPW[",
    "H[P[NZMYLWLQMONNPMSMUNVOWQWWVYUZS[P[",
    "H[MMMb RMNOMSMUNVOWQWWVYUZS[O[MZ", # /* U+70 P_SMALL  */
    "I\\WMWb RWZU[Q[OZNYMWMQNOONQMUMWN",
    "KXP[PM RPQQORNTMVM",
    "J[NZP[T[VZWXWWVUTTQTOSNQNPONQMTMVN",
    "MYOMWM RRFRXSZU[W[",
    "H[VMV[ RMMMXNZP[S[UZVY",
    "JZMMR[WM",
    "G]JMN[RQV[ZM",
    "IZL[WM RLMW[",
    "JZMMR[ RWMR[P`OaMb",
    "IZLMWML[W[",
    "KYVcUcSbR`RVQTOSQRRPRFSDUCVC",
    "H\\RbRD",
    "KYNcOcQbR`RVSTUSSRRPRFQDOCNC",
    "KZMSNRPQTSVRWQ",
    "F^K[KFYFY[K[",
    # /* // LATIN-1 SUPPLEMENT (0080-00FF) */
    "F^K[KFYFY[K[", # /* U+80 */
    "F^K[KFYFY[K[",
    "F^K[KFYFY[K[",
    "F^K[KFYFY[K[",
    "F^K[KFYFY[K[",
    "F^K[KFYFY[K[",
    "F^K[KFYFY[K[",
    "F^K[KFYFY[K[",
    "F^K[KFYFY[K[",
    "F^K[KFYFY[K[",
    "F^K[KFYFY[K[",
    "F^K[KFYFY[K[",
    "F^K[KFYFY[K[",
    "F^K[KFYFY[K[",
    "F^K[KFYFY[K[",
    "F^K[KFYFY[K[",
    "F^K[KFYFY[K[", # /* U+90 */
    "F^K[KFYFY[K[",
    "F^K[KFYFY[K[",
    "F^K[KFYFY[K[",
    "F^K[KFYFY[K[",
    "F^K[KFYFY[K[",
    "F^K[KFYFY[K[",
    "F^K[KFYFY[K[",
    "F^K[KFYFY[K[",
    "F^K[KFYFY[K[",
    "F^K[KFYFY[K[",
    "F^K[KFYFY[K[",
    "F^K[KFYFY[K[",
    "F^K[KFYFY[K[",
    "F^K[KFYFY[K[",
    "F^K[KFYFY[K[",
    "JZ", # /* U+A0 SPACE  */
    "MWROQNRMSNRORM RRUSaRbQaRURb",
    "HZVZT[P[NZMYLWLQMONNPMTMVN RRJR^",
    "H[LMTM RL[W[ RO[OIPGRFUFWG",
    "H]LYOV RLLOO RVVYY RVOYL RVVTWQWOVNTNQOOQNTNVOWQWTVV",
    "F^JTZT RJMZM RRQR[ RKFRQYF",
    "MWRbRW RRFRQ",
    "I[N]P^S^U]V[UYOSNQNPONQM RVGTFQFOGNIOKUQVSVTUVSW",
    "LXNFOGNHMGNFNH RVFWGVHUGVFVH",
    "@dVKTJPJNKLMKOKSLUNWPXTXVW RRCMDHGELDQEVH[M^R_W^\\[_V`Q_L\\GWDRC",
    "KZOEQDSDUEVGVN RVMTNQNOMNKOIQHVH",
    "H\\RMLSRY RXWTSXO",
    "E_JQZQZV",
    "RR",
    "@dWXRR RNXNJTJVKWMWOVQTRNR RRCMDHGELDQEVH[M^R_W^\\[_V`Q_L\\GWDRC",
    "LXMGWG",
    "JZRFPGOIPKRLTKUITGRF", # /* U+B0 DEGREE  */
    "E_JOZO RRWRG RZ[J[",
    "JZNAP@S@UAVCVEUGNNVN",
    "JZN@V@RESEUFVHVKUMSNPNNM",
    "NVTEQH",
    "H^MMMb RWXXZZ[ RMXNZP[T[VZWXWM",
    "F]VMV[ ROMOXNZL[ RZMMMKNJP",
    "JZRRQSRTSSRRRT",
    "MWR\\T]U_TaRbOb",
    "JZVNNN RNCPBR@RN",
    "KYQNOMNKNGOEQDSDUEVGVKUMSNQN",
    "H\\RMXSRY RLWPSLO",
    "G]KQYQ RVNNN RNCPBR@RN RUYUa RQSN]W]",
    "G]KQYQ RVNNN RNCPBR@RN RNTPSSSUTVVVXUZNaVa",
    "G]KQYQ RN@V@RESEUFVHVKUMSNPNNM RUYUa RQSN]W]",
    "I[SORNSMTNSOSM RWaUbPbNaM_M]N[OZQYRXSVSU",
    "I[MUWU RK[RFY[ RP>SA", # /* U+C0 A_CAP GRAVE */
    "I[MUWU RK[RFY[ RT>QA",
    "I[MUWU RK[RFY[ RNAR>VA",
    "I[MUWU RK[RFY[ RMAN@P?TAV@W?",
    "I[MUWU RK[RFY[ RN?O@NAM@N?NA RV?W@VAU@V?VA",
    "I[MUWU RK[RFY[ RRFPEOCPAR@TAUCTERF",
    "F`JURU RRPYP RH[OF\\F RRFR[\\[",
    "F[WYVZS[Q[NZLXKVJRJOKKLINGQFSFVGWH RR\\T]U_TaRbOb",
    "H[MPTP RW[M[MFWF RP>SA",
    "H[MPTP RW[M[MFWF RT>QA",
    "H[MPTP RW[M[MFWF RNAR>VA",
    "H[MPTP RW[M[MFWF RN?O@NAM@N?NA RV?W@VAU@V?VA",
    "MWR[RF RP>SA",
    "MWR[RF RT>QA",
    "MWR[RF RNAR>VA",
    "MWR[RF RN?O@NAM@N?NA RV?W@VAU@V?VA",
    "G\\L[LFQFTGVIWKXOXRWVVXTZQ[L[ RIPQP", # /* U+D0 D_CAP STROKE_H */
    "G]L[LFX[XF RMAN@P?TAV@W?",
    "G]PFTFVGXIYMYTXXVZT[P[NZLXKTKMLINGPF RP>SA",
    "G]PFTFVGXIYMYTXXVZT[P[NZLXKTKMLINGPF RT>QA",
    "G]PFTFVGXIYMYTXXVZT[P[NZLXKTKMLINGPF RNAR>VA",
    "G]PFTFVGXIYMYTXXVZT[P[NZLXKTKMLINGPF RMAN@P?TAV@W?",
    "G]PFTFVGXIYMYTXXVZT[P[NZLXKTKMLINGPF RN?O@NAM@N?NA RV?W@VAU@V?VA",
    "E_LMXY RXMLY",
    "G]ZFJ[ RP[NZLXKTKMLINGPFTFVGXIYMYTXXVZT[P[",
    "G]LFLWMYNZP[T[VZWYXWXF RP>SA",
    "G]LFLWMYNZP[T[VZWYXWXF RT>QA",
    "G]LFLWMYNZP[T[VZWYXWXF RNAR>VA",
    "G]LFLWMYNZP[T[VZWYXWXF RN?O@NAM@N?NA RV?W@VAU@V?VA",
    "I[RQR[ RKFRQYF RT>QA",
    "G\\LFL[ RLKTKVLWMXOXRWTVUTVLV",
    "F]K[KJLHMGOFRFTGUHVJVMSMQNPPPQQSSTVTXUYWYXXZV[R[PZ",
    "I\\W[WPVNTMPMNN RWZU[P[NZMXMVNTPSUSWR RPESH", # /* U+E0 A_SMALL GRAVE */
    "I\\W[WPVNTMPMNN RWZU[P[NZMXMVNTPSUSWR RTEQH",
    "I\\W[WPVNTMPMNN RWZU[P[NZMXMVNTPSUSWR RNHREVH",
    "I\\W[WPVNTMPMNN RWZU[P[NZMXMVNTPSUSWR RMHNGPFTHVGWF",
    "I\\W[WPVNTMPMNN RWZU[P[NZMXMVNTPSUSWR RNFOGNHMGNFNH RVFWGVHUGVFVH",
    "I\\W[WPVNTMPMNN RWZU[P[NZMXMVNTPSUSWR RRHPGOEPCRBTCUETGRH",
    "D`INKMOMQNRP R[ZY[U[SZRXRPSNUMYM[N\\P\\RRSKSITHVHXIZK[O[QZRX",
    "HZVZT[P[NZMYLWLQMONNPMTMVN RR\\T]U_TaRbOb",
    "I[VZT[P[NZMXMPNNPMTMVNWPWRMT RPESH",
    "I[VZT[P[NZMXMPNNPMTMVNWPWRMT RTEQH",
    "I[VZT[P[NZMXMPNNPMTMVNWPWRMT RNHREVH",
    "I[VZT[P[NZMXMPNNPMTMVNWPWRMT RNFOGNHMGNFNH RVFWGVHUGVFVH",
    "MWR[RM RPESH",
    "MWR[RM RTEQH",
    "LXNHREVH RR[RM",
    "LXNFOGNHMGNFNH RVFWGVHUGVFVH RR[RM",
    "I\\SCQI RWNUMQMONNOMQMXNZP[T[VZWXWLVITGRFNE", # /* U+F0 ETH_SMALL  */
    "I\\NMN[ RNOONQMTMVNWPW[ RMHNGPFTHVGWF",
    "H[P[NZMYLWLQMONNPMSMUNVOWQWWVYUZS[P[ RPESH",
    "H[P[NZMYLWLQMONNPMSMUNVOWQWWVYUZS[P[ RTEQH",
    "H[P[NZMYLWLQMONNPMSMUNVOWQWWVYUZS[P[ RNHREVH",
    "H[P[NZMYLWLQMONNPMSMUNVOWQWWVYUZS[P[ RMHNGPFTHVGWF",
    "H[P[NZMYLWLQMONNPMSMUNVOWQWWVYUZS[P[ RNFOGNHMGNFNH RVFWGVHUGVFVH",
    "E_ZSJS RRXSYRZQYRXRZ RRLSMRNQMRLRN",
    "H[XMK[ RP[NZMYLWLQMONNPMSMUNVOWQWWVYUZS[P[",
    "H[VMV[ RMMMXNZP[S[UZVY RPESH",
    "H[VMV[ RMMMXNZP[S[UZVY RTEQH",
    "H[VMV[ RMMMXNZP[S[UZVY RNHREVH",
    "H[VMV[ RMMMXNZP[S[UZVY RNFOGNHMGNFNH RVFWGVHUGVFVH",
    "JZMMR[ RWMR[P`OaMb RTEQH",
    "H[MFMb RMNOMSMUNVOWQWWVYUZS[O[MZ",
    "JZMMR[ RWMR[P`OaMb RNFOGNHMGNFNH RVFWGVHUGVFVH",
    # /* // LATIN EXTENDED-A (0100-017F) */
    "I[MUWU RK[RFY[ RM@W@", # /* U+100 A_CAP MACRON */
    "I\\W[WPVNTMPMNN RWZU[P[NZMXMVNTPSUSWR RMGWG",
    "I[MUWU RK[RFY[ RN>O@QASAU@V>",
    "I\\W[WPVNTMPMNN RWZU[P[NZMXMVNTPSUSWR RNEOGQHSHUGVE",
    "I[MUWU RK[RFY[ RY[W]V_WaYb[b",
    "I\\W[WPVNTMPMNN RWZU[P[NZMXMVNTPSUSWR RW[U]T_UaWbYb",
    "F[WYVZS[Q[NZLXKVJRJOKKLINGQFSFVGWH RT>QA",
    "HZVZT[P[NZMYLWLQMONNPMTMVN RTEQH",
    "F[WYVZS[Q[NZLXKVJRJOKKLINGQFSFVGWH RNAR>VA",
    "HZVZT[P[NZMYLWLQMONNPMTMVN RNHREVH",
    "F[WYVZS[Q[NZLXKVJRJOKKLINGQFSFVGWH RR?Q@RAS@R?RA",
    "HZVZT[P[NZMYLWLQMONNPMTMVN RRFQGRHSGRFRH",
    "F[WYVZS[Q[NZLXKVJRJOKKLINGQFSFVGWH RN>RAV>",
    "HZVZT[P[NZMYLWLQMONNPMTMVN RNERHVE",
    "G\\L[LFQFTGVIWKXOXRWVVXTZQ[L[ RN>RAV>",
    "IfW[WF RWZU[Q[OZNYMWMQNOONQMUMWN RbF`J",
    "G\\L[LFQFTGVIWKXOXRWVVXTZQ[L[ RIPQP", # /* U+110 D_CAP STROKE_H */
    "I\\W[WF RWZU[Q[OZNYMWMQNOONQMUMWN RRHZH",
    "H[MPTP RW[M[MFWF RM@W@",
    "I[VZT[P[NZMXMPNNPMTMVNWPWRMT RMGWG",
    "H[MPTP RW[M[MFWF RN>O@QASAU@V>",
    "I[VZT[P[NZMXMPNNPMTMVNWPWRMT RNEOGQHSHUGVE",
    "H[MPTP RW[M[MFWF RR?Q@RAS@R?RA",
    "I[VZT[P[NZMXMPNNPMTMVNWPWRMT RRFQGRHSGRFRH",
    "H[MPTP RW[M[MFWF RR[P]O_PaRbTb",
    "I[VZT[P[NZMXMPNNPMTMVNWPWRMT RR[P]O_PaRbTb",
    "H[MPTP RW[M[MFWF RN>RAV>",
    "I[VZT[P[NZMXMPNNPMTMVNWPWRMT RNERHVE",
    "F[VGTFQFNGLIKKJOJRKVLXNZQ[S[VZWYWRSR RNAR>VA",
    "I\\WMW^V`UaSbPbNa RWZU[Q[OZNYMWMQNOONQMUMWN RNHREVH",
    "F[VGTFQFNGLIKKJOJRKVLXNZQ[S[VZWYWRSR RN>O@QASAU@V>",
    "I\\WMW^V`UaSbPbNa RWZU[Q[OZNYMWMQNOONQMUMWN RNEOGQHSHUGVE",
    "F[VGTFQFNGLIKKJOJRKVLXNZQ[S[VZWYWRSR RR?Q@RAS@R?RA", # /* U+120 G_CAP DOT */
    "I\\WMW^V`UaSbPbNa RWZU[Q[OZNYMWMQNOONQMUMWN RRFQGRHSGRFRH",
    "F[VGTFQFNGLIKKJOJRKVLXNZQ[S[VZWYWRSR RR\\T]U_TaRbOb",
    "I\\WMW^V`UaSbPbNa RWZU[Q[OZNYMWMQNOONQMUMWN RRGPFODPBRAUA",
    "G]L[LF RLPXP RX[XF RNAR>VA",
    "H[M[MF RV[VPUNSMPMNNMO RIAM>QA",
    "G]IJ[J RL[LF RLPXP RX[XF",
    "H[M[MF RV[VPUNSMPMNNMO RJHRH",
    "MWR[RF RMAN@P?TAV@W?",
    "MWR[RM RMHNGPFTHVGWF",
    "MWR[RF RM@W@",
    "MWR[RM RMGWG",
    "MWR[RF RN>O@QASAU@V>",
    "MWR[RM RNEOGQHSHUGVE",
    "MWR[RF RR[P]O_PaRbTb",
    "MWR[RM RR[P]O_PaRbTb",
    "MWR[RF RR?Q@RAS@R?RA", # /* U+130 I_CAP DOT */
    "MWR[RM",
    "MgR[RF RbFbUaX_Z\\[Z[",
    "MaR[RM RRFQGRHSGRFRH R\\M\\_[aYbXb R\\F[G\\H]G\\F\\H",
    "JZUFUUTXRZO[M[ RQAU>YA",
    "MWRMR_QaObNb RNHREVH",
    "G\\L[LF RX[OO RXFLR RR\\T]U_TaRbOb",
    "IZN[NF RPSV[ RVMNU RR\\T]U_TaRbOb",
    "IZNMN[ RPSV[ RVMNU",
    "HYW[M[MF RO>LA",
    "MXU[SZRXRF RTEQH",
    "HYW[M[MF RR\\T]U_TaRbOb",
    "MXU[SZRXRF RR\\T]U_TaRbOb",
    "HYW[M[MF RVHSK",
    "M^U[SZRXRF RZFXJ",
    "HYW[M[MF RUNTOUPVOUNUP",
    "M\\U[SZRXRF RYOZPYQXPYOYQ", # /* U+140 L_SMALL_MIDDOT  */
    "HYW[M[MF RJQPM",
    "MXU[SZRXRF ROQUM",
    "G]L[LFX[XF RT>QA",
    "I\\NMN[ RNOONQMTMVNWPW[ RTEQH",
    "G]L[LFX[XF RR\\T]U_TaRbOb",
    "I\\NMN[ RNOONQMTMVNWPW[ RR\\T]U_TaRbOb",
    "G]L[LFX[XF RN>RAV>",
    "I\\NMN[ RNOONQMTMVNWPW[ RNERHVE",
    "MjSFQJ R\\M\\[ R\\O]N_MbMdNePe[",
    "G]LFL[ RLINGPFTFVGWHXJX^W`VaTbQb",
    "I\\NMN[ RNOONQMTMVNWPW_VaTbRb",
    "G]PFTFVGXIYMYTXXVZT[P[NZLXKTKMLINGPF RM@W@",
    "H[P[NZMYLWLQMONNPMSMUNVOWQWWVYUZS[P[ RMGWG",
    "G]PFTFVGXIYMYTXXVZT[P[NZLXKTKMLINGPF RN>O@QASAU@V>",
    "H[P[NZMYLWLQMONNPMSMUNVOWQWWVYUZS[P[ RNEOGQHSHUGVE",
    "G]PFTFVGXIYMYTXXVZT[P[NZLXKTKMLINGPF RQ>NA RX>UA", # /* U+150 O_CAP ACUTE_DBL */
    "H[P[NZMYLWLQMONNPMSMUNVOWQWWVYUZS[P[ RQENH RXEUH",
    "E`RPYP RRFR[ R\\FNFLGJIIMITJXLZN[\\[",
    "C`[ZY[U[SZRXRPSNUMYM[N\\P\\RRT RRQQOPNNMKMINHOGQGWHYIZK[N[PZQYRW",
    "G\\X[QQ RL[LFTFVGWHXJXMWOVPTQLQ RT>QA",
    "KXP[PM RPQQORNTMVM RTEQH",
    "G\\X[QQ RL[LFTFVGWHXJXMWOVPTQLQ RR\\T]U_TaRbOb",
    "KXP[PM RPQQORNTMVM RR\\T]U_TaRbOb",
    "G\\X[QQ RL[LFTFVGWHXJXMWOVPTQLQ RN>RAV>",
    "KXP[PM RPQQORNTMVM RNERHVE",
    "H\\LZO[T[VZWYXWXUWSVRTQPPNOMNLLLJMHNGPFUFXG RT>QA",
    "J[NZP[T[VZWXWWVUTTQTOSNQNPONQMTMVN RTEQH",
    "H\\LZO[T[VZWYXWXUWSVRTQPPNOMNLLLJMHNGPFUFXG RNAR>VA",
    "J[NZP[T[VZWXWWVUTTQTOSNQNPONQMTMVN RNHREVH",
    "H\\LZO[T[VZWYXWXUWSVRTQPPNOMNLLLJMHNGPFUFXG RR\\T]U_TaRbOb",
    "J[NZP[T[VZWXWWVUTTQTOSNQNPONQMTMVN RR\\T]U_TaRbOb",
    "H\\LZO[T[VZWYXWXUWSVRTQPPNOMNLLLJMHNGPFUFXG RN>RAV>", # /* U+160 S_CAP CARON */
    "J[NZP[T[VZWXWWVUTTQTOSNQNPONQMTMVN RNERHVE",
    "JZLFXF RR[RF RR\\T]U_TaRbOb",
    "MYOMWM RRFRXSZU[W[ RR\\T]U_TaRbOb",
    "JZLFXF RR[RF RN>RAV>",
    "M[OMWM RYFXI RRFRXSZU[W[",
    "JZLFXF RR[RF RNQVQ",
    "MYOMWM RRFRXSZU[W[ ROSUS",
    "G]LFLWMYNZP[T[VZWYXWXF RMAN@P?TAV@W?",
    "H[VMV[ RMMMXNZP[S[UZVY RMHNGPFTHVGWF",
    "G]LFLWMYNZP[T[VZWYXWXF RM@W@",
    "H[VMV[ RMMMXNZP[S[UZVY RMGWG",
    "G]LFLWMYNZP[T[VZWYXWXF RN>O@QASAU@V>",
    "H[VMV[ RMMMXNZP[S[UZVY RNEOGQHSHUGVE",
    "G]LFLWMYNZP[T[VZWYXWXF RRAP@O>P<R;T<U>T@RA",
    "H[VMV[ RMMMXNZP[S[UZVY RRHPGOEPCRBTCUETGRH",
    "G]LFLWMYNZP[T[VZWYXWXF RQ>NA RX>UA", # /* U+170 U_CAP ACUTE_DBL */
    "H[VMV[ RMMMXNZP[S[UZVY RQENH RXEUH",
    "G]LFLWMYNZP[T[VZWYXWXF RR[P]O_PaRbTb",
    "H[VMV[ RMMMXNZP[S[UZVY RV[T]S_TaVbXb",
    "F^IFN[RLV[[F RNAR>VA",
    "G]JMN[RQV[ZM RNHREVH",
    "I[RQR[ RKFRQYF RNAR>VA",
    "JZMMR[ RWMR[P`OaMb RNHREVH",
    "JZLFXF RR[RF RN?O@NAM@N?NA RV?W@VAU@V?VA",
    "H\\KFYFK[Y[ RT>QA",
    "IZLMWML[W[ RTEQH",
    "H\\KFYFK[Y[ RR?Q@RAS@R?RA",
    "IZLMWML[W[ RRFQGRHSGRFRH",
    "H\\KFYFK[Y[ RN>RAV>",
    "IZLMWML[W[ RNERHVE",
    "MYR[RISGUFWF",
    # /* // LATIN EXTENDED-B (0180-024F) */
    "H[M[MF RMNOMSMUNVOWQWWVYUZS[O[MZ RJHRH", # /* U+180 B_SMALL STROKE_H */
    "C\\LFL[T[VZWYXWXTWRVQSPLP RFKFIGGIFSFUGVHWJWLVNUOSP",
    "G\\VFLFL[R[UZWXXVXSWQUORNLN",
    "H[WFMFM[ RMNOMSMUNVOWQWWVYUZS[O[MZ",
    "H]MFM[S[VZXXYVYSXQVOSNMN",
    "IZNMN[S[UZVXVUUSSRNR",
    "I^MHNGQFSFVGXIYKZOZRYVXXVZS[Q[NZMY",
    "F[WYVZS[Q[NZLXKVJRJOKKLINGQFSFVGWH RMHKGJEKCLB",
    "HZVZT[P[NZMYLWLQMONNPMTMVN RTMTIUGWFYF",
    "G\\L[LFQFTGVIWKXOXRWVVXTZQ[L[ RIPQP",
    "C\\FKFIGGIFQFTGVIWKXOXRWVVXTZQ[L[LF",
    "H]NFXFX[R[OZMXLVLSMQOORNXN",
    "I\\MFWFW[ RWNUMQMONNOMQMWNYOZQ[U[WZ",
    "I\\Q[T[VZWYXWXQWOVNTMQMONNOMQMWNYOZQ[T\\V]W_VaTbPbNa",
    "I\\WPPP RM[W[WFMF",
    "F^MHNGQFSFVGXIYKZOZRYVXXVZS[Q[NZLXKVJRZP",
    "G[PPTP RWGUFPFNGMHLJLLMNNOPPMQLRKTKWLYMZO[U[WZ", # /* U+190 EPSILON_LARGE  */
    "HZTPMP RM[MFWF RM[M_LaJbHb",
    "MYOMWM RR[RISGUFWF RR[R_QaObMb",
    "F[VGTFQFNGLIKKJOJRKVLXNZQ[S[VZWYWRSR RMHKGJEKCLB",
    "I[KFU[U_TaRbPaO_O[YF",
    "D`I[IF RIOJNLMOMQNRPRXSZU[X[ZZ[Y\\W\\P[NZM",
    "MZRFRWSYTZV[X[",
    "MWR[RF RNPVP",
    "G_L[LF RX[OO RLRWGYF[G\\I\\K",
    "IZNMN[ RPSV[ RVMNU RNMNIOGQFSF",
    "MXU[SZRXRF RNOVO",
    "JZRMM[ RMFOFPGRMW[ RNLTH",
    "Ca\\F\\[ R\\XZZX[V[TZSYRWRF RRWQYPZN[L[JZIYHWHF",
    "G]L[LFX[XF RL[L_KaIbGb",
    "I\\NMN[ RNOONQMTMVNWPWb",
    "G]KPYP RPFTFVGXIYMYTXXVZT[P[NZLXKTKMLINGPF",
    "G]PFTFVGXIYMYTXXVZT[P[NZLXKTKMLINGPF RVGXFYDXBWA", # /* U+1A0 O_CAP HORN */
    "H[P[NZMYLWLQMONNPMSMUNVOWQWWVYUZS[P[ RUNWMXKWIVH",
    "DaSGQFMFKGIIHMHTIXKZM[Q[SZUXVTVMUISGUFYF[G\\I\\b",
    "E^RNPMMMKNJOIQIWJYKZM[P[RZSYTWTQSORNTMVMXNYPYb",
    "C\\LFL[ RFKFIGGIFTFVGWHXJXMWOVPTQLQ",
    "H[MMMb RMNOMSMUNVOWQWWVYUZS[O[MZ RRMRISGUFWF",
    "G\\LFL[ RQVXb RLKTKVLWMXOXRWTVUTVLV",
    "H\\XZU[P[NZMYLWLUMSNRPQTPVOWNXLXJWHVGTFOFLG",
    "IZVZT[P[NZMXMWNUPTSTUSVQVPUNSMPMNN",
    "H[W[L[SPLFWF",
    "JYWbUbSaR_RIQGOFMGLIMKOLQKRI",
    "MYOMWM RRFRXSZU[W[ RW[W_VaTbRb",
    "HZR[RF RKKKILGNFXF",
    "MYOMWM RWFUFSGRIRXSZU[W[",
    "JZLFXF RR[RF RR[R_SaUbWb",
    "G]LFLWMYNZP[T[VZWYXWXF RXFZE[CZAY@",
    "H[VMV[ RMMMXNZP[S[UZVY RVMXLYJXHWG", # /* U+1B0 U_SMALL HORN */
    "F^ZFUFUJWKYMZPZUYXWZT[P[MZKXJUJPKMMKOJOFJF",
    "G]LFLWMYNZP[T[VZXXYVYIXGWF",
    "I`RQR[ RKFRQXGZF\\G]I]K",
    "J^MMR[ RMbOaP`R[VNXMZN[P[R",
    "H\\KFYFK[Y[ RNPVP",
    "IZLMWML[W[ RNTVT",
    "H\\KFXFQNTNVOWPXRXWWYVZT[N[LZKY",
    "H\\YFLFSNPNNOMPLRLWMYNZP[V[XZYY",
    "JZWMNMUVRVPWOXNZN^O`PaRbUbWa",
    "JZMMVMOTSTUUVWVXUZS[Q[O\\N^N_OaQbVb",
    "H\\LHMGOFTFVGWHXJXLWOK[X[ RNSVS",
    "H\\WFMFLPMOONTNVOWPXRXWWYVZT[O[MZLY",
    "JZVMOMNSPRSRUSVUVXUZS[P[NZ",
    "J^MZP[T[WZYXZVZSYQWOTNPNPF RLITI",
    "H[MMMb RMONNPMTMVNWPWSVUM^",
    "MWRFRb", # /* U+1C0 LINE_V_LETTER  */
    "JZOFOb RUFUb",
    "MWRFRb ROWUW ROQUQ",
    "MWRYSZR[QZRYR[ RRSQGRFSGRSRF",
    "GpL[LFQFTGVIWKXOXRWVVXTZQ[L[ R_FmF_[m[ Rb>fAj>",
    "GmL[LFQFTGVIWKXOXRWVVXTZQ[L[ R_MjM_[j[ RaEeHiE",
    "ImW[WF RWZU[Q[OZNYMWMQNOONQMUMWN R_MjM_[j[ RaEeHiE",
    "HiW[M[MF RdFdUcXaZ^[\\[",
    "HcW[M[MF R^M^_]a[bZb R^F]G^H_G^F^H",
    "MbU[SZRXRF R]M]_\\aZbYb R]F\\G]H^G]F]H",
    "GmL[LFX[XF RhFhUgXeZb[`[",
    "GgL[LFX[XF RbMb_aa_b^b RbFaGbHcGbFbH",
    "IfNMN[ RNOONQMTMVNWPW[ RaMa_`a^b]b RaF`GaHbGaFaH",
    "I[MUWU RK[RFY[ RN>RAV>",
    "I\\W[WPVNTMPMNN RWZU[P[NZMXMVNTPSUSWR RNERHVE",
    "MWR[RF RN>RAV>",
    "MWR[RM RNERHVE", # /* U+1D0 I_SMALL CARON */
    "G]PFTFVGXIYMYTXXVZT[P[NZLXKTKMLINGPF RN>RAV>",
    "H[P[NZMYLWLQMONNPMSMUNVOWQWWVYUZS[P[ RNERHVE",
    "G]LFLWMYNZP[T[VZWYXWXF RN>RAV>",
    "H[VMV[ RMMMXNZP[S[UZVY RNERHVE",
    "G]LFLWMYNZP[T[VZWYXWXF RN?O@NAM@N?NA RV?W@VAU@V?VA RM;W;",
    "H[VMV[ RMMMXNZP[S[UZVY RNFOGNHMGNFNH RVFWGVHUGVFVH RM@W@",
    "G]LFLWMYNZP[T[VZWYXWXF RN?O@NAM@N?NA RV?W@VAU@V?VA RT9Q<",
    "H[VMV[ RMMMXNZP[S[UZVY RNFOGNHMGNFNH RVFWGVHUGVFVH RT>QA",
    "G]LFLWMYNZP[T[VZWYXWXF RN?O@NAM@N?NA RV?W@VAU@V?VA RN9R<V9",
    "H[VMV[ RMMMXNZP[S[UZVY RNFOGNHMGNFNH RVFWGVHUGVFVH RN>RAV>",
    "G]LFLWMYNZP[T[VZWYXWXF RN?O@NAM@N?NA RV?W@VAU@V?VA RP9S<",
    "H[VMV[ RMMMXNZP[S[UZVY RNFOGNHMGNFNH RVFWGVHUGVFVH RP>SA",
    "I[NNPMTMVNWPWXVZT[P[NZMXMVWT",
    "I[MUWU RK[RFY[ RN?O@NAM@N?NA RV?W@VAU@V?VA RM;W;",
    "I\\W[WPVNTMPMNN RWZU[P[NZMXMVNTPSUSWR RNFOGNHMGNFNH RVFWGVHUGVFVH RM@W@",
    "I[MUWU RK[RFY[ RR?Q@RAS@R?RA RM;W;", # /* U+1E0 A_CAP DOT */
    "I\\W[WPVNTMPMNN RWZU[P[NZMXMVNTPSUSWR RRFQGRHSGRFRH RM@W@",
    "F`JURU RRPYP RH[OF\\F RRFR[\\[ RO@Y@",
    "D`INKMOMQNRP R[ZY[U[SZRXRPSNUMYM[N\\P\\RRSKSITHVHXIZK[O[QZRX RMGWG",
    "F[VGTFQFNGLIKKJOJRKVLXNZQ[S[VZWYWRSR RSV[V",
    "I\\WMW^V`UaSbPbNa RWZU[Q[OZNYMWMQNOONQMUMWN RS^[^",
    "F[VGTFQFNGLIKKJOJRKVLXNZQ[S[VZWYWRSR RN>RAV>",
    "I\\WMW^V`UaSbPbNa RWZU[Q[OZNYMWMQNOONQMUMWN RNERHVE",
    "G\\L[LF RX[OO RXFLR RN>RAV>",
    "IZN[NF RPSV[ RVMNU RJANDRA",
    "G]R[P]O_PaRbTb RPFTFVGXIYMYTXXVZT[P[NZLXKTKMLINGPF",
    "H[R[P]O_PaRbTb RP[NZMYLWLQMONNPMSMUNVOWQWWVYUZS[P[",
    "G]R[P]O_PaRbTb RPFTFVGXIYMYTXXVZT[P[NZLXKTKMLINGPF RM@W@",
    "H[R[P]O_PaRbTb RP[NZMYLWLQMONNPMSMUNVOWQWWVYUZS[P[ RMGWG",
    "H\\KFXFQNTNVOWPXRXWWYVZT[N[LZKY RN>RAV>",
    "JZMMVMOVRVTWUXVZV^U`TaRbObMa RNERHVE",
    "MWRMR_QaObNb RNERHVE", # /* U+1F0 J_SMALL CARON */
    "GpL[LFQFTGVIWKXOXRWVVXTZQ[L[ R_FmF_[m[",
    "GmL[LFQFTGVIWKXOXRWVVXTZQ[L[ R_MjM_[j[",
    "ImW[WF RWZU[Q[OZNYMWMQNOONQMUMWN R_MjM_[j[",
    "F[VGTFQFNGLIKKJOJRKVLXNZQ[S[VZWYWRSR RT>QA",
    "I\\WMW^V`UaSbPbNa RWZU[Q[OZNYMWMQNOONQMUMWN RTEQH",
    "CaH[HF RHPTP RTFTXUZW[Z[\\Z]X]M",
    "G\\LFLb RLINGPFTFVGWHXJXOWRUUL^",
    "G]L[LFX[XF RP>SA",
    "I\\NMN[ RNOONQMTMVNWPW[ RPESH",
    "I[MUWU RK[RFY[ RZ9X< RR;P<O>P@RAT@U>T<R;",
    "I\\W[WPVNTMPMNN RWZU[P[NZMXMVNTPSUSWR RZ@XC RRBPCOEPGRHTGUETCRB",
    "F`JURU RRPYP RH[OF\\F RRFR[\\[ RV>SA",
    "D`INKMOMQNRP R[ZY[U[SZRXRPSNUMYM[N\\P\\RRSKSITHVHXIZK[O[QZRX RTEQH",
    "G]ZFJ[ RP[NZLXKTKMLINGPFTFVGXIYMYTXXVZT[P[ RT>QA",
    "H[XMK[ RP[NZMYLWLQMONNPMSMUNVOWQWWVYUZS[P[ RTEQH",
    "I[MUWU RK[RFY[ ROAL> RVAS>", # /* U+200 A_CAP GRAVE_DBL */
    "I\\W[WPVNTMPMNN RWZU[P[NZMXMVNTPSUSWR ROHLE RVHSE",
    "I[MUWU RK[RFY[ RNAO?Q>S>U?VA",
    "I\\W[WPVNTMPMNN RWZU[P[NZMXMVNTPSUSWR RNHOFQESEUFVH",
    "H[MPTP RW[M[MFWF ROAL> RVAS>",
    "I[VZT[P[NZMXMPNNPMTMVNWPWRMT ROHLE RVHSE",
    "H[MPTP RW[M[MFWF RNAO?Q>S>U?VA",
    "I[VZT[P[NZMXMPNNPMTMVNWPWRMT RNHOFQESEUFVH",
    "MWR[RF ROAL> RVAS>",
    "MWR[RM ROHLE RVHSE",
    "MWR[RF RNAO?Q>S>U?VA",
    "MWR[RM RNHOFQESEUFVH",
    "G]PFTFVGXIYMYTXXVZT[P[NZLXKTKMLINGPF ROAL> RVAS>",
    "H[P[NZMYLWLQMONNPMSMUNVOWQWWVYUZS[P[ ROHLE RVHSE",
    "G]PFTFVGXIYMYTXXVZT[P[NZLXKTKMLINGPF RNAO?Q>S>U?VA",
    "H[P[NZMYLWLQMONNPMSMUNVOWQWWVYUZS[P[ RNHOFQESEUFVH",
    "G\\X[QQ RL[LFTFVGWHXJXMWOVPTQLQ ROAL> RVAS>", # /* U+210 R_CAP GRAVE_DBL */
    "KXP[PM RPQQORNTMVM RPHME RWHTE",
    "G\\X[QQ RL[LFTFVGWHXJXMWOVPTQLQ RNAO?Q>S>U?VA",
    "KXP[PM RPQQORNTMVM ROHPFRETEVFWH",
    "G]LFLWMYNZP[T[VZWYXWXF ROAL> RVAS>",
    "H[VMV[ RMMMXNZP[S[UZVY ROHLE RVHSE",
    "G]LFLWMYNZP[T[VZWYXWXF RNAO?Q>S>U?VA",
    "H[VMV[ RMMMXNZP[S[UZVY RNHOFQESEUFVH",
    "H\\LZO[T[VZWYXWXUWSVRTQPPNOMNLLLJMHNGPFUFXG RS`SaRcQd",
    "J[NZP[T[VZWXWWVUTTQTOSNQNPONQMTMVN RS`SaRcQd",
    "JZLFXF RR[RF RS`SaRcQd",
    "MYOMWM RRFRXSZU[W[ RU`UaTcSd",
    "I]VRXTYVY[X]V_T`Lb RLHMGOFUFWGXHYJYNXPVRTSNU",
    "J[UWVXWZW]V_U`SaMb RMNOMSMUNVOWQWTVVUWSXOY",
    "G]L[LF RLPXP RX[XF RN>RAV>",
    "H[M[MF RV[VPUNSMPMNNMO RI>MAQ>",
    "G]L[LFX[XF RX[Xb", # /* U+220 N_CAP LEG */
    "IbWFWXXZZ[\\[^Z_X^V\\UZVV^ RWNUMQMONNOMQMWNYOZQ[T[VZWX",
    "G]NFLGKIKKLMMNOO RVFXGYIYKXMWNUO ROOUOWPXQYSYWXYWZU[O[MZLYKWKSLQMPOO",
    "J[MJMMNORQVOWMWJ RPQTQVRWTWXVZT[P[NZMXMTNRPQ",
    "H\\KFYFK[Y[ RY[Y_XaVbTb",
    "IZLMWML[W[ RW[W_VaTbRb",
    "I[MUWU RK[RFY[ RR?Q@RAS@R?RA",
    "I\\W[WPVNTMPMNN RWZU[P[NZMXMVNTPSUSWR RRFQGRHSGRFRH",
    "H[MPTP RW[M[MFWF RR\\T]U_TaRbOb",
    "I[VZT[P[NZMXMPNNPMTMVNWPWRMT RR\\T]U_TaRbOb",
    "G]PFTFVGXIYMYTXXVZT[P[NZLXKTKMLINGPF RN?O@NAM@N?NA RV?W@VAU@V?VA RM;W;",
    "H[P[NZMYLWLQMONNPMSMUNVOWQWWVYUZS[P[ RNFOGNHMGNFNH RVFWGVHUGVFVH RM@W@",
    "G]PFTFVGXIYMYTXXVZT[P[NZLXKTKMLINGPF RMAN@P?TAV@W? RM;W;",
    "H[P[NZMYLWLQMONNPMSMUNVOWQWWVYUZS[P[ RMHNGPFTHVGWF RM@W@",
    "G]PFTFVGXIYMYTXXVZT[P[NZLXKTKMLINGPF RR?Q@RAS@R?RA",
    "H[P[NZMYLWLQMONNPMSMUNVOWQWWVYUZS[P[ RRFQGRHSGRFRH",
    "G]PFTFVGXIYMYTXXVZT[P[NZLXKTKMLINGPF RR?Q@RAS@R?RA RM;W;", # /* U+230 O_CAP DOT */
    "H[P[NZMYLWLQMONNPMSMUNVOWQWWVYUZS[P[ RRFQGRHSGRFRH RM@W@",
    "I[RQR[ RKFRQYF RM@W@",
    "JZMMR[ RWMR[P`OaMb RMGWG",
    "M]RFRXSZU[W[YZZXYVWUUVQ^",
    "IbNMN[ RNOONQMTMVNWPWXXZZ[\\[^Z_X^V\\UZVV^",
    "M]OMWM RRFRXSZU[W[YZZXYVWUUVQ^",
    "MWRMR_QaObNb",
    "D`R[RF RRZP[L[JZIYHWHQIOJNLMPMRN RTMXMZN[O\\Q\\W[YZZX[T[RZ",
    "D`RMRb RRZP[L[JZIYHWHQIOJNLMPMRN RTMXMZN[O\\Q\\W[YZZX[T[RZ",
    "I[MUWU RK[RFY[ RXCL`",
    "F[WYVZS[Q[NZLXKVJRJOKKLINGQFSFVGWH RXCL`",
    "HZVZT[P[NZMYLWLQMONNPMTMVN RWHM`",
    "HYW[M[MF RIOQO",
    "JZLFXF RR[RF RXCL`",
    "J[P[R^T_W_ RNZP[T[VZWXWWVUTTQTOSNQNPONQMTMVN",
    "IZLMWML[N[P\\R^T_W_", # /* U+240 Z_SMALL_SWASHTAIL  */
    "J^MGPFTFWGYIZKZNYPWRTSPSP[",
    "J^NNPMTMVNWOXQXSWUVVTWPWP[",
    "G\\SPVQWRXTXWWYVZT[L[LFSFUGVHWJWLVNUOSPLP RIUOU",
    "G]IM[M RLFLWMYNZP[T[VZWYXWXF",
    "I[Y[RFK[",
    "H[MPTP RW[M[MFWF RXCL`",
    "I[VZT[P[NZMXMPNNPMTMVNWPWRMT RWHM`",
    "JZUFUUTXRZO[M[ RQPYP",
    "MWRMR_QaObNb ROTUT RRFQGRHSGRFRH",
    "G]XFX^Y`Za\\b^b RXIVGTFPFNGLIKMKTLXNZP[T[VZXX",
    "I\\WMW^X`Ya[b]b RWZU[Q[OZNYMWMQNOONQMUMWN",
    "G\\X[QQ RL[LFTFVGWHXJXMWOVPTQLQ RIQOQ",
    "KXP[PM RPQQORNTMVM RMTUT",
    "I[KIYI RRQR[ RKFRQYF",
    "JZLQXQ RMMR[ RWMR[P`OaMb",
    # /* // IPA EXTENSIONS (0250-02AF) */
    "H[MMMXNZP[T[VZ RMNOMTMVNWPWRVTTUOUMV", # /* U+250 +A_SMALL  */
    "H]YMVWUYTZR[P[NZMYLVLRMONNPMRMTNUOVQWXXZZ[",
    "G\\K[NQOOPNRMTMVNWOXRXVWYVZT[R[PZOYNWMPLNJM",
    "H[RFPFNGMIM[ RMNOMSMUNVOWQWWVYUZS[O[MZ",
    "J\\NNPMTMVNWOXQXWWYVZT[P[NZ",
    "HZVNTMPMNNMOLQLWMYNZP[S[UZVXUVSUQVM^",
    "I\\W[WF RWZU[Q[OZNYMWMQNOONQMUMWN RW[W_XaZb\\b",
    "I\\\\FZFXGWIW[ RWZU[Q[OZNYMWMQNOONQMUMWN",
    "I[NZP[T[VZWXWPVNTMPMNNMPMRWT",
    "I[NNPMTMVNWPWXVZT[P[NZMXMVWT",
    "IbNNPMTMVNWPWXVZT[P[NZMXMV\\S\\U]W_X`X",
    "IZPTNUMWMXNZP[T[VZ RRTPTNSMQMPNNPMTMVN",
    "J[TTVSWQWPVNTMPMNN RRTTTVUWWWXVZT[P[NZ",
    "JaRTTTVUWWWXVZT[P[NZ RNNPMTMVNWPWQVSTT[S[U\\W^X_X",
    "H[TTVSWQWPVNTMPMNNMOLRLVMYNZP[T[VZWXWWVUTTRT",
    "MWRMR_QaObNb ROTUT",
    "I\\WMW^V`UaSbPbNa RWZU[Q[OZNYMWMQNOONQMUMWN RWMWIXGZF\\F", # /* U+260 G_SMALL +HOOK */
    "I\\WYVZT[P[NZMXMQNOONQMWMW^V`UaSbMb",
    "HZUNSMPMNNMOLQLWMYNZP[T[VZVUSU",
    "JZMMU[U_TaRbPaO_O[WM",
    "JZMMTVUXTZR[PZOXPVWM",
    "I\\WMWb RNMNXOZQ[T[VZWY",
    "H[RFPFNGMIM[ RV[VPUNSMPMNNMO",
    "H[RFPFNGMIM[ RV[VPUNSMPMNNMO RV[V_UaSbQb",
    "MWR[RM ROTUT RRFQGRHSGRFRH",
    "MXRMRXSZU[",
    "MWR[RM RU[O[ RUMOM",
    "MXU[SZRXRF RMONNPMTOVNWM",
    "IYU[SZRXRF RRQQOONMOLQMSOTWT",
    "MXRFR_SaUbWb",
    "GZLFLXMZO[ RLMVMOVRVTWUXVZV^U`TaRbObMa",
    "D`[M[[ R[YZZX[U[SZRXRM RRXQZO[L[JZIXIM",
    "D`[M[[ R[YZZX[U[SZRXRM RRXQZO[L[JZIXIM R[[[b", # /* U+270 +M_SMALL LEG */
    "D`I[IM RIOJNLMOMQNRPR[ RRPSNUMXMZN[P[[ R[[[_ZaXbVb",
    "I\\NMN[ RNOONQMTMVNWPW[ RN[N_MaKbIb",
    "I\\NMN[ RNOONQMTMVNWPW[ RW[W_XaZb\\b",
    "H[M[MMV[VM",
    "H[LTWT RP[NZMYLWLQMONNPMSMUNVOWQWWVYUZS[P[",
    "E]RTXT RRMR[ RZMMMKNJOIQIWJYKZM[Z[",
    "G]RTRXSZU[V[XZYXYQXOWNUMOMMNLOKQKXLZN[O[QZRX",
    "G]RFRb RPMTMVNXPYRYVXXVZT[P[NZLXKVKRLPNNPM",
    "LYTMT[ RTWSYRZP[N[",
    "LYTMT[ RTWSYRZP[N[ RTMTF",
    "LYTMT[ RTWSYRZP[N[ RT[T_UaWbYb",
    "KXP[PM RPQQORNTMVM RP[Pb",
    "KXP[PM RPQQORNTMVM RP[P_QaSbUb",
    "KXM[S[ RVMTMRNQOPRP[",
    "LYW[Q[ RNMPMRNSOTRT[",
    "I[RUW[ RN[NMTMVNWPWRVTTUNU", # /* U+280 R_SMALLCAP  */
    "I[RSWM RNMN[T[VZWXWVVTTSNS",
    "J[NZP[T[VZWXWWVUTTQTOSNQNPONQMTMVN RN[N_OaQbSb",
    "KYWFUFSGRIR_QaObMb",
    "MWRMR_QaObNb ROTUT RRMRISGUFWF",
    "KYMFOFQGRIRXSZU[W[",
    "KYWFUFSGRIR_QaObMaL_M]O\\V\\",
    "KWU[M[ RRbRPQNOMMM",
    "MYOMWM RRFR_SaUbWb",
    "H[JRYR RVMV[ RMMMXNZP[S[UZVY",
    "I\\XMUMUPWRXTXWWYVZT[Q[OZNYMWMTNRPPPMMM",
    "H[MMMXNZP[S[UZVYWWWPVNUM",
    "JZW[RMM[",
    "G]Z[VMRWNMJ[",
    "JZW[RM RM[RMTHUGWF",
    "KYRTR[ RMMRTWM",
    "IZLMWML[W[ RW[W_XaZb\\b", # /* U+290 Z_SMALL !HOOK */
    "IZLMWML[T[VZWXVVTURVN^",
    "JZMMVMOVRVTWUXVZV^U`TaRbObMa",
    "JZMMVMOVRVTWUXVZV^U`TaRbPbNaM_N]P\\R]Uc",
    "J^MGPFTFWGYIZKZNYPWRTSPSP[",
    "FZWGTFPFMGKIJKJNKPMRPSTST[",
    "J^MZP[T[WZYXZVZSYQWOTNPNPF",
    "F[WHVGSFQFNGLIKKJOJYK]L_NaQbSbVaW`",
    "G]PFTFVGXIYMYTXXVZT[P[NZLXKTKMLINGPF RROQPRQSPRORQ",
    "I[STVUWWWXVZT[N[NMSMUNVPVQUSSTNT",
    "I\\PTNUMWMXNZP[T[VZWYXVXRWOVNTMPMNNMPMQNSPTRT",
    "HZUNSMPMNNMOLQLWMYNZP[T[VZVUSU RUMUIVGXFZF",
    "H[MTVT RMMM[ RVMV[",
    "LXRMR_QaObMaL_M]O\\V\\ RRFQGRHSGRFRH",
    "J[VMVb RTUNM RN[VS",
    "JYOMO[V[",
    "I\\WMWb RWZU[Q[OZNYMWMQNOONQMUMWN RWMWIXGZF\\F", # /* U+2A0 Q_SMALL +HOOK */
    "J^MGPFTFWGYIZKZNYPWRTSPSP[ RLXTX",
    "FZWGTFPFMGKIJKJNKPMRPSTST[ RPXXX",
    "D`R[RF RRM]MR[][ RRZP[L[JZIYHWHQIOJNLMPMRN",
    "E`RFR[ RRNPMMMKNJOIQIWJYKZM[P[RZ RRM\\MUVXVZW[X\\Z\\^[`ZaXbUbSa",
    "D`R[RF RRM]MR[Z[\\Z]X\\VZUXVT^ RRZP[L[JZIYHWHQIOJNLMPMRN",
    "G^IMQM RLFLXMZO[QZS[W[YZZXZWYUWTTTRSQQQPRNTMWMYN",
    "I[KMTM RNFNXOZQ[T[ RYFWFUGTIT_SaQbOb",
    "F^HMPM RKFKXLZN[P[RZ RZNXMTMRNQOPQPWQYRZT[W[YZZXYVWUUVQ^",
    "F]HMPMP[ RK[KILGNFPF RPOQNSMVMXNYPY_XaVbTb",
    "G^LFLXMZO[QZS[W[YZZXZWYUWTTTRSQQQPRNTMWMYN",
    "H^MM[MP[ RMFMXNZP[[[",
    "G]JSN[RUV[ZS RJFNNRHVNZF",
    "G]XXXSLSLX RXKXFLFLK",
    "I\\WMWb RNMNXOZQ[T[VZWY RNMNIMGKFIF",
    "I\\\\bZbXaW_WM RNMNXOZQ[T[VZWY RNMNIMGKFIF",
    # /* // SPACING MODIFIER LETTERS (02B0-02FF) */
    "F^K[KFYFY[K[", # /* U+2B0 */
    "F^K[KFYFY[K[",
    "F^K[KFYFY[K[",
    "F^K[KFYFY[K[",
    "F^K[KFYFY[K[",
    "F^K[KFYFY[K[",
    "F^K[KFYFY[K[",
    "F^K[KFYFY[K[",
    "F^K[KFYFY[K[",
    "F^K[KFYFY[K[",
    "F^K[KFYFY[K[",
    "F^K[KFYFY[K[",
    "F^K[KFYFY[K[",
    "F^K[KFYFY[K[",
    "F^K[KFYFY[K[",
    "F^K[KFYFY[K[",
    "F^K[KFYFY[K[", # /* U+2C0 */
    "F^K[KFYFY[K[",
    "F^K[KFYFY[K[",
    "F^K[KFYFY[K[",
    "F^K[KFYFY[K[",
    "F^K[KFYFY[K[",
    "F^K[KFYFY[K[",
    "F^K[KFYFY[K[",
    "F^K[KFYFY[K[",
    "F^K[KFYFY[K[",
    "F^K[KFYFY[K[",
    "F^K[KFYFY[K[",
    "F^K[KFYFY[K[",
    "F^K[KFYFY[K[",
    "F^K[KFYFY[K[",
    "F^K[KFYFY[K[",
    "F^K[KFYFY[K[", # /* U+2D0 */
    "F^K[KFYFY[K[",
    "F^K[KFYFY[K[",
    "F^K[KFYFY[K[",
    "F^K[KFYFY[K[",
    "F^K[KFYFY[K[",
    "F^K[KFYFY[K[",
    "F^K[KFYFY[K[",
    "F^K[KFYFY[K[",
    "F^K[KFYFY[K[",
    "F^K[KFYFY[K[",
    "F^K[KFYFY[K[",
    "F^K[KFYFY[K[",
    "F^K[KFYFY[K[",
    "F^K[KFYFY[K[",
    "F^K[KFYFY[K[",
    "F^K[KFYFY[K[", # /* U+2E0 */
    "F^K[KFYFY[K[",
    "F^K[KFYFY[K[",
    "F^K[KFYFY[K[",
    "F^K[KFYFY[K[",
    "F^K[KFYFY[K[",
    "F^K[KFYFY[K[",
    "F^K[KFYFY[K[",
    "F^K[KFYFY[K[",
    "F^K[KFYFY[K[",
    "F^K[KFYFY[K[",
    "F^K[KFYFY[K[",
    "F^K[KFYFY[K[",
    "F^K[KFYFY[K[",
    "F^K[KFYFY[K[",
    "F^K[KFYFY[K[",
    "F^K[KFYFY[K[", # /* U+2F0 */
    "F^K[KFYFY[K[",
    "F^K[KFYFY[K[",
    "F^K[KFYFY[K[",
    "F^K[KFYFY[K[",
    "F^K[KFYFY[K[",
    "F^K[KFYFY[K[",
    "F^K[KFYFY[K[",
    "F^K[KFYFY[K[",
    "F^K[KFYFY[K[",
    "F^K[KFYFY[K[",
    "F^K[KFYFY[K[",
    "F^K[KFYFY[K[",
    "F^K[KFYFY[K[",
    "F^K[KFYFY[K[",
    "F^K[KFYFY[K[",
    # /* // COMBINING DIACRITICAL MARKS (0300-036F) */
    "F^K[KFYFY[K[", # /* U+300 */
    "F^K[KFYFY[K[",
    "F^K[KFYFY[K[",
    "F^K[KFYFY[K[",
    "F^K[KFYFY[K[",
    "F^K[KFYFY[K[",
    "F^K[KFYFY[K[",
    "F^K[KFYFY[K[",
    "F^K[KFYFY[K[",
    "F^K[KFYFY[K[",
    "F^K[KFYFY[K[",
    "F^K[KFYFY[K[",
    "F^K[KFYFY[K[",
    "F^K[KFYFY[K[",
    "F^K[KFYFY[K[",
    "F^K[KFYFY[K[",
    "F^K[KFYFY[K[", # /* U+310 */
    "F^K[KFYFY[K[",
    "F^K[KFYFY[K[",
    "F^K[KFYFY[K[",
    "F^K[KFYFY[K[",
    "F^K[KFYFY[K[",
    "F^K[KFYFY[K[",
    "F^K[KFYFY[K[",
    "F^K[KFYFY[K[",
    "F^K[KFYFY[K[",
    "F^K[KFYFY[K[",
    "F^K[KFYFY[K[",
    "F^K[KFYFY[K[",
    "F^K[KFYFY[K[",
    "F^K[KFYFY[K[",
    "F^K[KFYFY[K[",
    "F^K[KFYFY[K[", # /* U+320 */
    "F^K[KFYFY[K[",
    "F^K[KFYFY[K[",
    "F^K[KFYFY[K[",
    "F^K[KFYFY[K[",
    "F^K[KFYFY[K[",
    "F^K[KFYFY[K[",
    "F^K[KFYFY[K[",
    "F^K[KFYFY[K[",
    "F^K[KFYFY[K[",
    "F^K[KFYFY[K[",
    "F^K[KFYFY[K[",
    "F^K[KFYFY[K[",
    "F^K[KFYFY[K[",
    "F^K[KFYFY[K[",
    "F^K[KFYFY[K[",
    "F^K[KFYFY[K[", # /* U+330 */
    "F^K[KFYFY[K[",
    "F^K[KFYFY[K[",
    "F^K[KFYFY[K[",
    "F^K[KFYFY[K[",
    "F^K[KFYFY[K[",
    "F^K[KFYFY[K[",
    "F^K[KFYFY[K[",
    "F^K[KFYFY[K[",
    "F^K[KFYFY[K[",
    "F^K[KFYFY[K[",
    "F^K[KFYFY[K[",
    "F^K[KFYFY[K[",
    "F^K[KFYFY[K[",
    "F^K[KFYFY[K[",
    "F^K[KFYFY[K[",
    "F^K[KFYFY[K[", # /* U+340 */
    "F^K[KFYFY[K[",
    "F^K[KFYFY[K[",
    "F^K[KFYFY[K[",
    "F^K[KFYFY[K[",
    "F^K[KFYFY[K[",
    "F^K[KFYFY[K[",
    "F^K[KFYFY[K[",
    "F^K[KFYFY[K[",
    "F^K[KFYFY[K[",
    "F^K[KFYFY[K[",
    "F^K[KFYFY[K[",
    "F^K[KFYFY[K[",
    "F^K[KFYFY[K[",
    "F^K[KFYFY[K[",
    "F^K[KFYFY[K[",
    "F^K[KFYFY[K[", # /* U+350 */
    "F^K[KFYFY[K[",
    "F^K[KFYFY[K[",
    "F^K[KFYFY[K[",
    "F^K[KFYFY[K[",
    "F^K[KFYFY[K[",
    "F^K[KFYFY[K[",
    "F^K[KFYFY[K[",
    "F^K[KFYFY[K[",
    "F^K[KFYFY[K[",
    "F^K[KFYFY[K[",
    "F^K[KFYFY[K[",
    "F^K[KFYFY[K[",
    "F^K[KFYFY[K[",
    "F^K[KFYFY[K[",
    "F^K[KFYFY[K[",
    "F^K[KFYFY[K[", # /* U+360 */
    "F^K[KFYFY[K[",
    "F^K[KFYFY[K[",
    "F^K[KFYFY[K[",
    "F^K[KFYFY[K[",
    "F^K[KFYFY[K[",
    "F^K[KFYFY[K[",
    "F^K[KFYFY[K[",
    "F^K[KFYFY[K[",
    "F^K[KFYFY[K[",
    "F^K[KFYFY[K[",
    "F^K[KFYFY[K[",
    "F^K[KFYFY[K[",
    "F^K[KFYFY[K[",
    "F^K[KFYFY[K[",
    "F^K[KFYFY[K[",
    # /* // GREEK AND COPTIC (0370-03FF) */
    "H[MFM[ RXPMP", # /* U+370 HETA_CAP  */
    "IZNTVT RNMN[",
    "G]R[RF RKOKFYFYO",
    "I[R[RF RMOMFWFWO",
    "MWSFQJ",
    "MWS[Q_",
    "G]LFL[XFX[",
    "H\\MMM[WMW[",
    "F^K[KFYFY[K[",
    "F^K[KFYFY[K[",
    "NVR`RcSdTd",
    "J\\NZP[T[VZWYXWXQWOVNTMPMNN",
    "HZVZT[P[NZMYLWLQMONNPMTMVN RRSQTRUSTRSRU",
    "J\\NZP[T[VZWYXWXQWOVNTMPMNN RRSQTRUSTRSRU",
    "MWSZS[R]Q^ RRNSORPQORNRP",
    "F^K[KFYFY[K[",
    "F^K[KFYFY[K[", # /* U+380 */
    "F^K[KFYFY[K[",
    "F^K[KFYFY[K[",
    "F^K[KFYFY[K[",
    "NVTEQH",
    "LXNFOGNHMGNFNH RVFWGVHUGVFVH RT>QA",
    "G[MUWU RK[RFY[ RMEJH",
    "JZRRQSRTSSRRRT",
    "B[MPTP RW[M[MFWF RHEEH",
    "A]L[LF RLPXP RX[XF RGEDH",
    "GWR[RF RMEJH",
    "RR",
    "B]PFTFVGXIYMYTXXVZT[P[NZLXKTKMLINGPF RHEEH",
    "RR",
    "@[RQR[ RKFRQYF RFECH",
    "@^J[O[OWMVKTJQJLKIMGPFTFWGYIZLZQYTWVUWU[Z[ RFECH",
    "MXRMRXSZU[ RNFOGNHMGNFNH RVFWGVHUGVFVH RT>QA", # /* U+390 IOTA_SMALL DIAERESIS */
    "I[MUWU RK[RFY[",
    "G\\SPVQWRXTXWWYVZT[L[LFSFUGVHWJWLVNUOSPLP",
    "HZM[MFXF",
    "I[K[RFY[K[",
    "H[MPTP RW[M[MFWF",
    "H\\KFYFK[Y[",
    "G]L[LF RLPXP RX[XF",
    "F^OPUP RPFTFVGXIYKZNZSYVXXVZT[P[NZLXKVJSJNKKLINGPF",
    "MWR[RF",
    "G\\L[LF RX[OO RXFLR",
    "I[K[RFY[",
    "F^K[KFRUYFY[",
    "G]L[LFX[XF",
    "H[L[W[ RLFWF RUPNP",
    "G]PFTFVGXIYMYTXXVZT[P[NZLXKTKMLINGPF",
    "G]L[LFXFX[", # /* U+3A0 PI_CAP  */
    "G\\L[LFTFVGWHXJXMWOVPTQLQ",
    "RR",
    "H[W[L[SPLFWF",
    "JZLFXF RR[RF",
    "I[RQR[ RKFRQYF",
    "G]R[RF RPITIWJYLZNZRYTWVTWPWMVKTJRJNKLMJPI",
    "H\\KFY[ RYFK[",
    "G]R[RF RHFJGKIKNLQMROSUSWRXQYNYIZG\\F",
    "F^J[O[OWMVKTJQJLKIMGPFTFWGYIZLZQYTWVUWU[Z[",
    "MWR[RF RN?O@NAM@N?NA RV?W@VAU@V?VA",
    "I[RQR[ RKFRQYF RN?O@NAM@N?NA RV?W@VAU@V?VA",
    "H]YMVWUYTZR[P[NZMYLVLRMONNPMRMTNUOVQWXXZZ[ RTEQH",
    "IZPTNUMWMXNZP[T[VZ RRTPTNSMQMPNNPMTMVN RTEQH",
    "I\\NMN[ RNOONQMTMVNWPWb RTEQH",
    "MXRMRXSZU[ RTEQH",
    "H[MMMXNZP[S[UZVYWWWPVNUM RNFOGNHMGNFNH RVFWGVHUGVFVH RT>QA", # /* U+3B0 UPSILON_SMALL DIAERESIS */
    "H]YMVWUYTZR[P[NZMYLVLRMONNPMRMTNUOVQWXXZZ[",
    "H[SOUPVQWSWWVYUZS[P[NZMY RKbLaM_MINGPFSFUGVIVLUNSOQO",
    "JZRYRb RLMMMNNRYWM",
    "H[SMPMNNMOLQLWMYNZP[S[UZVYWWWQVOUNSMPLNKMINGPFTFVG",
    "IZPTNUMWMXNZP[T[VZ RRTPTNSMQMPNNPMTMVN",
    "HZMFWFPMNPMSMWNYOZQ[S[U\\V^V_UaSbRb",
    "I\\NMN[ RNOONQMTMVNWPWb",
    "H[LPWP RPFSFUGVHWKWVVYUZS[P[NZMYLVLKMHNGPF",
    "MXRMRXSZU[",
    "IZNMN[ RPSV[ RVMNU",
    "JZRMM[ RMFOFPGRMW[",
    "H^MMMb RWXXZZ[ RMXNZP[T[VZWXWM",
    "J[MMR[WPWOVM",
    "HZMFWF RQFOGNINLONQOUO RQOOPNQMSMWNYOZQ[S[U\\V^V_UaSbRb",
    "H[P[NZMYLWLQMONNPMSMUNVOWQWWVYUZS[P[",
    "F]VMV[ ROMOXNZL[ RZMMMKNJP", # /* U+3C0 PI_SMALL  */
    "H\\MbMQNOONQMTMVNWOXQXWWYVZT[Q[OZMX",
    "HZVNTMPMNNMOLQLWMYNZP[S[U\\V^V_UaSb",
    "H\\YMPMNNMOLQLWMYNZP[S[UZVYWWWQVOUNSM",
    "H\\LPMNOMXM RRMRXSZU[",
    "H[MMMXNZP[S[UZVYWWWPVNUM",
    "G]MMLNKPKVLXNZP[T[VZXXYVYPXNVMUMSNRPRb",
    "IZWMLb RLMNNOPT_UaWb",
    "G]RMRb RKMKVLXNZP[T[VZXXYVYM",
    "G]RTRX RMMLNKPKXLZN[O[QZRXSZU[V[XZYXYPXNWM",
    "LXNFOGNHMGNFNH RVFWGVHUGVFVH RRMRXSZU[",
    "H[MMMXNZP[S[UZVYWWWPVNUM RNFOGNHMGNFNH RVFWGVHUGVFVH",
    "H[P[NZMYLWLQMONNPMSMUNVOWQWWVYUZS[P[ RTEQH",
    "H[MMMXNZP[S[UZVYWWWPVNUM RTEQH",
    "G]RTRX RMMLNKPKXLZN[O[QZRXSZU[V[XZYXYPXNWM RTEQH",
    "G\\L[LF RXFLR ROOX[Qb",
    "H[SOUPVQWSWWVYUZS[P[NZMXMINGPFSFUGVIVLUNSOQO", # /* U+3D0 BETA_SMALL_CURLED  */
    "H[JPKQLSLVMYNZP[S[UZVYWVWKVHUGSFPFNGMHLJLLMNNOPPWP",
    "I\\KFMFOGQIRKR[ RRKSHTGVFWFYGZI",
    "NiTEQH RXFZF\\G^I_K_[ R_K`HaGcFdFfGgI",
    "I\\KFMFOGQIRKR[ RRKSHTGVFWFYGZI RN?O@NAM@N?NA RV?W@VAU@V?VA",
    "G]RFRb RPMTMVNXPYRYVXXVZT[P[NZLXKVKRLPNNPM",
    "F^RTRX R[MIM RMMLNKPKXLZN[O[QZRXSZU[V[XZYXYPXNWM",
    "IZLMNNOPOXNZM[LZLXMVVRWPWNVMUNTPTXUZW[V^U`TaRb",
    "G]R[Rb RPFTFVGXIYMYTXXVZT[P[NZLXKTKMLINGPF",
    "H[R[Rb RP[NZMYLWLQMONNPMSMUNVOWQWWVYUZS[P[",
    "FZWFQFNGLIKKJOJRKVLXNZQ[R[T\\U^U_TaSbQb",
    "HZVMPMNNMOLQLWMYNZP[R[T\\U^U_TaRbPb",
    "HZTPMP RM[MFWF",
    "MZVPRP RWFUFSGRIR_QaOb",
    "H\\MFOGPILSXNTXUZW[",
    "I[RFMPWPR[",
    "H\\NGNL RXIULTNTW RKIMGPFTFVGXIYKZOZUYYX[", # /* U+3E0 SAMPI_CAP  */
    "H\\L[UR RR[WV RLMPNSPURWVXZXb",
    "CaRWRR R\\XY]V`SaMa RLFJGHIGLGUHXJZL[N[PZQYRWSYTZV[X[ZZ\\X]U]L\\IZGXF",
    "G]RTRX RXZW\\S`PaOa RMMLNKPKXLZN[O[QZRXSZU[V[XZYXYPXNWM",
    "G]XFXb RPFNGLIKMKTLXNZP[T[VZXX",
    "I\\WMWb RQMONNOMQMWNYOZQ[T[VZWY",
    "F]KFK[ RKQMOPNTNVOXQYTYWXZW\\U^R`Nb",
    "I[WLWMVPTRRSPSNRMPMONMPLRLTMVPWSWWVYUZS[M[",
    "F]KHLGOFTFWGXHYJYLXOVQJ[N^Q_V_Y^",
    "J[NNPMTMVNWPWRVTTVN[P]R^U^W]",
    "G]I[[[ RIFJFLGXZZ[ R[FZFXGLZJ[",
    "H[KMMNVZX[K[MZVNXM",
    "G\\XEVFOFMGLHKJKWLYMZO[T[VZWYXWXPWNVMTLNLLMKN",
    "H[WEVFTGPGNHMILKLWMYNZP[S[UZVYWWWQVOUNSMOMMNLO",
    "G]RFRb RKQKMYMYQ",
    "I[MMWM RRFRb",
    "IZLMNNOPOXNZM[LZLXMVVRWPWNVMUNTPTXUZW[", # /* U+3F0 KAPPA_SMALL_SCRIPT  */
    "H\\WbQbOaN`M^MQNOONQMTMVNWOXQXWWYVZT[Q[OZMX",
    "HZVZT[P[NZMYLWLQMONNPMTMVN",
    "MWRMR_QaObNb RRFQGRHSGRFRH",
    "G]KPYP RPFTFVGXIYMYTXXVZT[P[NZLXKTKMLINGPF",
    "HZLTST RVZT[P[NZMYLWLQMONNPMTMVN",
    "J\\XTQT RNZP[T[VZWYXWXQWOVNTMPMNN",
    "G\\LFL[ RLKTKVLWMXOXRWTVUTVLV",
    "H[MFMb RMNOMSMUNVOWQWWVYUZS[O[MZ",
    "F[WYVZS[Q[NZLXKVJRJOKKLINGQFSFVGWH",
    "F^K[KFRMYFY[",
    "G]LbLMRSXMX[",
    "G\\J`S` RMbMQNOONQMTMVNWOXQXWWYVZT[Q[OZMX",
    "I^MYNZQ[S[VZXXYVZRZOYKXIVGSFQFNGMH",
    "F[WYVZS[Q[NZLXKVJRJOKKLINGQFSFVGWH RROQPRQSPRORQ",
    "I^MYNZQ[S[VZXXYVZRZOYKXIVGSFQFNGMH RROQPRQSPRORQ",
    # /* // Cyrillic (0400-04FF) */
    "H[MPTP RW[M[MFWF RP>SA", # /* U+400 E_CAP GRAVE */
    "H[MPTP RW[M[MFWF RN?O@NAM@N?NA RV?W@VAU@V?VA",
    "JbLFXF RR[RF RRMXM[N]P^S^\\]_[aXbVb",
    "HZM[MFXF RT>QA",
    "F[JPTP RWYVZS[Q[NZLXKVJRJOKKLINGQFSFVGWH",
    "H\\LZO[T[VZWYXWXUWSVRTQPPNOMNLLLJMHNGPFUFXG",
    "MWR[RF",
    "MWR[RF RN?O@NAM@N?NA RV?W@VAU@V?VA",
    "JZUFUUTXRZO[M[",
    "AbC[D[FZGXILJILGOFRFR[X[[Z]X^V^S]Q[OXNRN",
    "AbF[FF RRFR[X[[Z]X^V^S]Q[OXNFN",
    "JbLFXF RR[RF RRMXM[N]P^S^[",
    "G\\L[LF RX[OO RXFLR RT>QA",
    "G]LFL[XFX[ RP>SA",
    "G[KFRT RYFPXNZL[K[ RN>O@QASAU@V>",
    "G]R[R` RLFL[X[XF",
    "I[MUWU RK[RFY[", # /* U+410 A_CAP  */
    "G\\VFLFL[R[UZWXXVXSWQUORNLN",
    "G\\SPVQWRXTXWWYVZT[L[LFSFUGVHWJWLVNUOSPLP",
    "HZM[MFXF",
    "F^[`[[I[I` RW[WFRFPGOHNJL[",
    "H[MPTP RW[M[MFWF",
    "BbOOF[ RR[RF RRRFF R^[UO R^FRR",
    "I]PPTP RMGOFTFVGWHXJXLWNVOTPWQXRYTYWXYWZU[O[MZ",
    "G]LFL[XFX[",
    "G]LFL[XFX[ RN>O@QASAU@V>",
    "G\\L[LF RX[OO RXFLR",
    "F\\W[WFTFQGOINLLXKZI[H[",
    "F^K[KFRUYFY[",
    "G]L[LF RLPXP RX[XF",
    "G]PFTFVGXIYMYTXXVZT[P[NZLXKTKMLINGPF",
    "G]L[LFXFX[",
    "G\\L[LFTFVGWHXJXMWOVPTQLQ", # /* U+420 P_CAP  */
    "F[WYVZS[Q[NZLXKVJRJOKKLINGQFSFVGWH",
    "JZLFXF RR[RF",
    "G[KFRT RYFPXNZL[K[",
    "G]R[RF RPITIWJYLZNZRYTWVTWPWMVKTJRJNKLMJPI",
    "H\\KFY[ RYFK[",
    "G]XFX[ RLFL[Z[Z`",
    "H\\WFW[ RLFLNMPNQPRWR",
    "CaRFR[ RHFH[\\[\\F",
    "CaRFR[ RHFH[\\[\\F R\\[^[^`",
    "F]HFMFM[S[VZXXYVYSXQVOSNMN",
    "Da\\F\\[ RIFI[O[RZTXUVUSTQROONIN",
    "H]MFM[S[VZXXYVYSXQVOSNMN",
    "I^ZQPQ RMHNGQFSFVGXIYKZOZRYVXXVZS[Q[NZMY",
    "CaHFH[ ROPHP RTFXFZG\\I]M]T\\XZZX[T[RZPXOTOMPIRGTF",
    "G\\RQK[ RW[WFOFMGLHKJKMLOMPOQWQ",
    "I\\W[WPVNTMPMNN RWZU[P[NZMXMVNTPSUSWR", # /* U+430 A_SMALL  */
    "H[WEVFTGPGNHMILKLWMYNZP[S[UZVYWWWQVOUNSMOMMNLO",
    "I[STVUWWWXVZT[N[NMSMUNVPVQUSSTNT",
    "JYO[OMWM",
    "H[WOVNTMPMNNMOLQLWMYNZP[S[UZVYWWWJVHUGSFOFMG",
    "I[VZT[P[NZMXMPNNPMTMVNWPWRMT",
    "F^QTJ[ RRUJM RRMR[ RZ[ST RZMRU",
    "K[RTTT RNNPMTMVNWPWQVSTTVUWWWXVZT[P[NZ",
    "H\\MMM[WMW[",
    "H\\MMM[WMW[ RNEOGQHSHUGVE",
    "IZNMN[ RPSV[ RVMNU",
    "I[V[VMSMQNPPOXNZL[",
    "G]L[LMRXXMX[",
    "H[MTVT RMMM[ RVMV[",
    "H[P[NZMYLWLQMONNPMSMUNVOWQWWVYUZS[P[",
    "H[M[MMVMV[",
    "H[MMMb RMNOMSMUNVOWQWWVYUZS[O[MZ", # /* U+440 P_SMALL  */
    "HZVZT[P[NZMYLWLQMONNPMTMVN",
    "KYMMWM RRMR[",
    "JZMMR[ RWMR[P`OaMb",
    "G]RFRb RPMTMVNXPYRYVXXVZT[P[NZLXKVKRLPNNPM",
    "IZL[WM RLMW[",
    "I\\WMW[ RNMN[Y[Y`",
    "J\\VMV[ RNMNROTQUVU",
    "F^RMR[ RKMK[Y[YM",
    "F^RMR[ RKMK[Y[YM RY[[[[`",
    "HZJMNMN[S[UZVXVUUSSRNR",
    "F^YMY[ RKMK[P[RZSXSURSPRKR",
    "IZNMN[S[UZVXVUUSSRNR",
    "J\\XTQT RNNPMTMVNWOXQXWWYVZT[P[NZ",
    "E_JTPT RJMJ[ RT[RZQYPWPQQORNTMWMYNZO[Q[WZYYZW[T[",
    "I[RUM[ RV[VMPMNNMPMRNTPUVU",
    "I[VZT[P[NZMXMPNNPMTMVNWPWRMT RPESH", # /* U+450 E_SMALL GRAVE */
    "I[VZT[P[NZMXMPNNPMTMVNWPWRMT RNFOGNHMGNFNH RVFWGVHUGVFVH",
    "M^OKXK RRFR[ RRSSRUQWQYRZTZ[Y^WaVb",
    "JYO[OMWM RTEQH",
    "HZLTST RVZT[P[NZMYLWLQMONNPMTMVN",
    "J[NZP[T[VZWXWWVUTTQTOSNQNPONQMTMVN",
    "MWR[RM RRFQGRHSGRFRH",
    "LXNFOGNHMGNFNH RVFWGVHUGVFVH RR[RM",
    "MWRMR_QaObNb RRFQGRHSGRFRH",
    "E^H[JZKXLPMNOMRMR[W[YZZXZUYSWRRR",
    "D^IMI[ RRMR[W[YZZXZVYTWSIS",
    "M^OKXK RRFR[ RRSSRUQWQYRZTZ[",
    "IZNMN[ RPSV[ RVMNU RTEQH",
    "H\\MMM[WMW[ RPESH",
    "JZMMR[ RWMR[P`OaMb RNEOGQHSHUGVE",
    "H]R[R` RMMM[W[WM",
    "CaRWRR RLFJGHIGLGUHXJZL[N[PZQYRWSYTZV[X[ZZ\\X]U]L\\IZGXF", # /* U+460 OMEGA_LARGE  */
    "G]RTRX RMMLNKPKXLZN[O[QZRXSZU[V[XZYXYPXNWM",
    "F]IIVI RMFM[S[VZXXYVYSXQVOSNMN",
    "HZJMTM RNFN[S[UZVXVUUSSRNR",
    "D`IFI[ RYPIP R\\Y[ZX[V[SZQXPVOROOPKQISGVFXF[G\\H",
    "F^KMK[ RWTKT RZZX[T[RZQYPWPQQORNTMXMZN",
    "F^LSXS RRSR[ RH[RF\\[",
    "I[NUVU RRUR[ RK[RMY[",
    "AbF[FF RFS\\S RVSV[ RL[VF`[",
    "E_J[JM RVUV[ RZUJU RO[VM][",
    "E_R[RPJFZFRP RI[IVJSLQOPUPXQZS[V[[",
    "G]R[RTLMXMRT RK[KXLVMUOTUTWUXVYXY[",
    "AcF[FF RFPSP RV[VPNF^FVP RM[MVNSPQSPYP\\Q^S_V_[",
    "DaI[IM RITST RV[VTPM\\MVT RO[OXPVQUSTYT[U\\V]X][",
    "H\\OPSP RNAQFSBTAUA RLGNFSFUGVHWJWLVNUOSPVQWRXTXWWYVZT[O[M\\L^L_MaObWb",
    "J[RTTT ROHRMTIUHVH RNNPMTMVNWPWQVSTTVUWWWXVZT[Q[O\\N^N_OaQbVb",
    "G]R[RF RHFJGKIKNLQMROSUSWRXQYNYIZG\\F", # /* U+470 PSI_CAP  */
    "G]RMRb RKMKVLXNZP[T[VZXXYVYM",
    "G]KPYP RPFTFVGXIYMYTXXVZT[P[NZLXKTKMLINGPF",
    "H[LTWT RP[NZMYLWLQMONNPMSMUNVOWQWWVYUZS[P[",
    "I[KFR[YF",
    "JZMMR[WM",
    "I[KFR[YF ROAL> RVAS>",
    "JZMMR[WM ROHLE RVHSE",
    "GmPFTFVGXIYMYTXXVZT[P[NZLXKTKMLINGPF R`Me[ RjMe[c`ba`b",
    "HkP[NZMYLWLQMONNPMSMUNVOWQWWVYUZS[P[ R^Mc[ RhMc[a``a^b",
    "CaRXR^ RRCRI RMFJGHIGLGUHXJZM[W[ZZ\\X]U]L\\IZGWFMF",
    "G]RYR] RRKRO ROMMNLOKQKWLYMZO[U[WZXYYWYQXOWNUMOM",
    "CaRWRR RLFJGHIGLGUHXJZL[N[PZQYRWSYTZV[X[ZZ\\X]U]L\\IZGXF RLBM@O?R?U@X@",
    "G]RTRX RMMLNKPKXLZN[O[QZRXSZU[V[XZYXYPXNWM RLIMGOFRFUGXG",
    "CaRWRR RLFJGHIGLGUHXJZL[N[PZQYRWSYTZV[X[ZZ\\X]U]L\\IZGXF RM<W< RR<R?",
    "G]RTRX RMMLNKPKXLZN[O[QZRXSZU[V[XZYXYPXNWM RMEWE RRERH",
    "FZWGTFPFMGKIJKJNKPMRPSTST[", # /* U+480 KOPPA_CYR_CAP  */
    "FZVNTMPMNNMOLQLSMUNVPWTWT[",
    "H[N]UO ROQWU RT[LW",
    "JZMHMFWGWE",
    "JZMHUEVH",
    "NVPESH",
    "NVTEQH",
    "KZLIMGOFRFUGXG",
    ":j>R?PAOCPDR RC^D\\F[H\\I^ RCFDDFCHDIF ROcPaR`TaUc ROAP?R>T?UA R[^\\\\^[`\\a^ R[F\\D^C`DaF R`RaPcOePfR",
    ":jDQ>Q RH[D_ RHGDC RR_Re RRCR= R\\[`_ R\\G`C R`QfQ",
    "G]LFL[XFX[ RX[[[Ub RN>O@QASAU@V>",
    "H\\MMM[WMW[ RW[Z[Tb RNEOGQHSHUGVE",
    "H]MFM[S[VZXXYVYSXQVOSNMN RJIPI",
    "IZKMQM RNFN[S[UZVXVUUSSRNR",
    "G\\L[LFTFVGWHXJXMWOVPTQLQ RTMXS",
    "H[MMMb RMNOMSMUNVOWQWWVYUZS[O[MZ RSWW]",
    "HZM[MFXFXA", # /* U+490 GAMMA_CAP_UPTURN  */
    "JYO[OMWMWH",
    "HZM[MFXF RJQRQ",
    "JYO[OMWM RLTTT",
    "H]M[MFXF RMMSMVNXPYSY\\X_VaSbQb",
    "J\\O[OMWM ROTTTVUWVXXX[W^UaTb",
    "BbOOF[ RR[RF RRRFF R^[UO R^FRR R^[`[``",
    "F^QTJ[ RRUJM RRMR[ RZ[ST RZMRU RZ[\\[\\`",
    "I]PPTP RMGOFTFVGWHXJXLWNVOTPWQXRYTYWXYWZU[O[MZ RR\\T]U_TaRbOb",
    "K[RTTT RNNPMTMVNWPWQVSTTVUWWWXVZT[P[NZ RR\\T]U_TaRbOb",
    "G\\L[LF RX[OO RXFLR RX[Z[Z`",
    "IZNMN[ RPSV[ RVMNU RV[X[X`",
    "G\\L[LF RX[OO RXFLR RPKPS",
    "IZNMN[ RPSV[ RVMNU RRORW",
    "G\\L[LF RX[OO RXFLR RIJOJ",
    "IZN[NF RPSV[ RVMNU RKJQJ",
    "E\\X[OO RXFLR RGFLFL[", # /* U+4A0 K_CAP_BASHKIR  */
    "HZPSV[ RVMNU RJMNMN[",
    "G]L[LF RLPXP RX[XF RX[Z[Z`",
    "H[MTVT RMMM[ RVMV[ RV[X[X`",
    "GeL[LF RLPXP RX[XFcF",
    "H`MTVT RMMM[ RV[VM^M",
    "GhL[LFXFX[ RXM^MaNcPdSd\\c_aa^b\\b",
    "HcM[MMVMV[ RVT[T]U^V_X_[^^\\a[b",
    "F^QFNGLIKKJOJRKVLXNZQ[S[VZXXYVZRZMYJWIVITJSMSRTVUXWZY[[[",
    "H\\QMPMNNMOLQLWMYNZP[T[VZWYXWXRWPUOSPRRRWSYTZV[Y[",
    "F[WYVZS[Q[NZLXKVJRJOKKLINGQFSFVGWH RR\\T]U_TaRbOb",
    "HZVZT[P[NZMYLWLQMONNPMTMVN RR\\T]U_TaRbOb",
    "JZLFXF RR[RF RR[T[T`",
    "KYMMWM RRMR[ RR[T[T`",
    "I[RQR[ RKFRQYF",
    "JZR[Rb RMMR[WM",
    "I[RQR[ RKFRQYF RNUVU", # /* U+4B0 Y_CAP STROKE_H */
    "JZR[Rb RMMR[WM RN]V]",
    "H\\KFY[ RYFK[ RX[Z[Z`",
    "IZL[WM RLMW[ RV[X[X`",
    "D]FFRF RXFX[ RLFL[Z[Z`",
    "G\\RMIM RWMW[ RNMN[Y[Y`",
    "H\\WFW[ RLFLNMPNQPRWR RW[Y[Y`",
    "J\\VMV[ RNMNROTQUVU RV[X[X`",
    "H\\WFW[ RLFLNMPNQPRWR RRNRV",
    "J\\VMV[ RNMNROTQUVU RRQRY",
    "G]L[LF RL[ RLPRPUQWSXVX[",
    "H[M[MF RV[VPUNSMPMNNMO",
    "@^WYVZS[Q[NZLXKVJRJOKKLINGQFSFVGXIYKZOJQGQEPDOCMCK",
    "E[VZT[P[NZMXMPNNPMTMVNWPWRMTKTISHQHO",
    "@^WYVZS[Q[NZLXKVJRJOKKLINGQFSFVGXIYKZOJQGQEPDOCMCK RR[P]O_PaRbTb",
    "E[VZT[P[NZMXMPNNPMTMVNWPWRMTKTISHQHO RR[P]O_PaRbTb",
    "MWR[RF", # /* U+4C0 I_CAP  */
    "BbOOF[ RR[RF RRRFF R^[UO R^FRR RN>O@QASAU@V>",
    "F^QTJ[ RRUJM RRMR[ RZ[ST RZMRU RNEOGQHSHUGVE",
    "G\\L[LF RX[OO RXFLR RX[X_WaUbSb",
    "IZNMN[ RPSV[ RVMNU RV[V_UaSbQb",
    "F\\W[WFTFQGOINLLXKZI[H[ RW[Z[Tb",
    "I[V[VMSMQNPPOXNZL[ RV[Y[Sb",
    "G]L[LF RLPXP RX[XF RX[X_WaUbSb",
    "H[MTVT RMMM[ RVMV[ RV[V_UaSbQb",
    "G]L[LF RLPXP RX[XF RX[[[Ub",
    "H[MTVT RMMM[ RVMV[ RV[Y[Sb",
    "H\\WFW[ RLFLNMPNQPRWR RW[U[U`",
    "J\\VMV[ RNMNROTQUVU RV[T[T`",
    "F^K[KFRUYFY[ RY[\\[Vb",
    "G]L[LMRXXMX[ RX[[[Ub",
    "MWR[RF",
    "I[MUWU RK[RFY[ RN>O@QASAU@V>", # /* U+4D0 A_CAP BREVE */
    "I\\W[WPVNTMPMNN RWZU[P[NZMXMVNTPSUSWR RNEOGQHSHUGVE",
    "I[MUWU RK[RFY[ RN?O@NAM@N?NA RV?W@VAU@V?VA",
    "I\\W[WPVNTMPMNN RWZU[P[NZMXMVNTPSUSWR RNFOGNHMGNFNH RVFWGVHUGVFVH",
    "F`JURU RRPYP RH[OF\\F RRFR[\\[",
    "D`INKMOMQNRP R[ZY[U[SZRXRPSNUMYM[N\\P\\RRSKSITHVHXIZK[O[QZRX",
    "H[MPTP RW[M[MFWF RN>O@QASAU@V>",
    "I[VZT[P[NZMXMPNNPMTMVNWPWRMT RNEOGQHSHUGVE",
    "F^MHNGQFSFVGXIYKZOZRYVXXVZS[Q[NZLXKVJRZP",
    "I[NNPMTMVNWPWXVZT[P[NZMXMVWT",
    "F^MHNGQFSFVGXIYKZOZRYVXXVZS[Q[NZLXKVJRZP RNBOCNDMCNBND RVBWCVDUCVBVD",
    "I[NNPMTMVNWPWXVZT[P[NZMXMVWT RNFOGNHMGNFNH RVFWGVHUGVFVH",
    "BbOOF[ RR[RF RRRFF R^[UO R^FRR RN?O@NAM@N?NA RV?W@VAU@V?VA",
    "F^QTJ[ RRUJM RRMR[ RZ[ST RZMRU RNFOGNHMGNFNH RVFWGVHUGVFVH",
    "I]PPTP RMGOFTFVGWHXJXLWNVOTPWQXRYTYWXYWZU[O[MZ RN?O@NAM@N?NA RV?W@VAU@V?VA",
    "K[RTTT RNNPMTMVNWPWQVSTTVUWWWXVZT[P[NZ RNFOGNHMGNFNH RVFWGVHUGVFVH",
    "H\\KFXFQNTNVOWPXRXWWYVZT[N[LZKY", # /* U+4E0 DIGIT_3  */
    "JZMMVMOVRVTWUXVZV^U`TaRbObMa",
    "G]LFL[XFX[ RM@W@",
    "H\\MMM[WMW[ RMGWG",
    "G]LFL[XFX[ RN?O@NAM@N?NA RV?W@VAU@V?VA",
    "H\\MMM[WMW[ RNFOGNHMGNFNH RVFWGVHUGVFVH",
    "G]PFTFVGXIYMYTXXVZT[P[NZLXKTKMLINGPF RN?O@NAM@N?NA RV?W@VAU@V?VA",
    "H[P[NZMYLWLQMONNPMSMUNVOWQWWVYUZS[P[ RNFOGNHMGNFNH RVFWGVHUGVFVH",
    "G]KPYP RPFTFVGXIYMYTXXVZT[P[NZLXKTKMLINGPF",
    "H[LTWT RP[NZMYLWLQMONNPMSMUNVOWQWWVYUZS[P[",
    "G]KPYP RPFTFVGXIYMYTXXVZT[P[NZLXKTKMLINGPF RN?O@NAM@N?NA RV?W@VAU@V?VA",
    "H[LTWT RP[NZMYLWLQMONNPMSMUNVOWQWWVYUZS[P[ RNFOGNHMGNFNH RVFWGVHUGVFVH",
    "I^ZPPP RMYNZQ[S[VZXXYVZRZOYKXIVGSFQFNGMH RN?O@NAM@N?NA RV?W@VAU@V?VA",
    "J\\XTQT RNZP[T[VZWYXWXQWOVNTMPMNN RNFOGNHMGNFNH RVFWGVHUGVFVH",
    "G[KFRT RYFPXNZL[K[ RM@W@",
    "JZMMR[ RWMR[P`OaMb RMGWG",
    "G[KFRT RYFPXNZL[K[ RN?O@NAM@N?NA RV?W@VAU@V?VA", # /* U+4F0 Y_LARGE DIAERESIS */
    "JZMMR[ RWMR[P`OaMb RNFOGNHMGNFNH RVFWGVHUGVFVH",
    "G[KFRT RYFPXNZL[K[ RQ>NA RX>UA",
    "JZMMR[ RWMR[P`OaMb RQENH RXEUH",
    "H\\WFW[ RLFLNMPNQPRWR RN?O@NAM@N?NA RV?W@VAU@V?VA",
    "J\\VMV[ RNMNROTQUVU RNFOGNHMGNFNH RVFWGVHUGVFVH",
    "HZM[MFXF RM[O[O`",
    "JYO[OMWM RO[Q[Q`",
    "Da\\F\\[ RIFI[O[RZTXUVUSTQROONIN RN?O@NAM@N?NA RV?W@VAU@V?VA",
    "F^YMY[ RKMK[P[RZSXSURSPRKR RNFOGNHMGNFNH RVFWGVHUGVFVH",
    "HZWFMFM[Q[Q_PaNbLb RJQRQ",
    "JYWMOMO[S[S_RaPbNb RLTTT",
    "H\\KFY[ RYFK[ RX[X_WaUbSb",
    "IZL[WM RLMW[ RV[V_UaSbQb",
    "H\\KFY[ RYFK[ RNPVP",
    "IZL[WM RLMW[ RNTVT",
    # /* // Cyrillic Supplement (500-52F) */
    "G\\WFW[Q[NZLXKVKSLQNOQNWN", # /* U+500 !SOFT_CAP  */
    "J[VMV[Q[OZNXNUOSQRVR",
    "B_RXSZU[X[ZZ[X[M RRFRXQZO[L[IZGXFVFSGQIOLNRN",
    "E]RXSZU[V[XZYXYQ RRMRXQZO[M[KZJXJUKSMRRR",
    "IePPTP RMGOFTFVGWHXJXLWNVOTPVQWRXTXXYZ[[^[`ZaXaM",
    "KbRTTT RNNPMTMVNWPWQVSTTVUWWWXXZZ[[[]Z^X^Q",
    "I\\PPTP RMGOFTFVGWHXJXLWNVOTPVQWRXTX[Z[Z`",
    "K[RTTT RNNPMTMVNWPWQVSTTVUWWW[Y[Y`",
    "FdH[I[KZLXNLOIQGTFWFWXXZZ[][_Z`X`M",
    "IaL[NZOXPPQNSMVMVXWZY[Z[\\Z]X]Q",
    "CaH[HF RHPTP RTFTXUZW[Z[\\Z]X]M",
    "F^KTTT RKMK[ RTMTXUZW[X[ZZ[X[R",
    "F[VGTFQFNGLIKKJOJRKVLXNZQ[S[VZWYWRSR",
    "HZUNSMPMNNMOLQLWMYNZP[T[VZVUSU",
    "J_LFXF RRFRXSZU[X[ZZ[X[M",
    "K]MMWM RRMRXSZU[V[XZYXYS",
    "G[PPTP RWGUFPFNGMHLJLLMNNOPPMQLRKTKWLYMZO[U[WZ", # /* U+510 EPSILON_LARGE  */
    "IZPTNUMWMXNZP[T[VZ RRTPTNSMQMPNNPMTMVN",
    "F\\W[WFTFQGOINLLXKZI[H[ RW[W_VaTbRb",
    "I[V[VMSMQNPPOXNZL[ RV[V_UaSbQb",
    "BaP[^F RD[E[GZHXJLKIMGPF^[",
    "E^[MO[ RH[JZKXLPMNOM[[",
    "E_\\FUO\\[ RJ[JFRFTGUHVJVMUOTPRQJQ",
    "F^KMKb R[MUT[[ RKNMMQMSNTOUQUWTYSZQ[M[KZ",
    "DaOQH[ RTFT[^[ R[QLQJPIOHMHJIHJGLF^F",
    "D`H[MU RRPRMKMINHPHRITKURU R[ZY[U[SZRXRPSNUMYM[N\\P\\RRT",
    "G]Z]X\\VZSWQVOV RP[NZLXKTKMLINGPFTFVGXIYMYTXXVZT[P[",
    "I\\WMWb RWZU[Q[OZNYMWMQNOONQMUMWN",
    "F^IFN[RLV[[F",
    "G]JMN[RQV[ZM",
    "G\\L[LF RX[OO RXFLR RXKRG",
    "IZNMN[ RPSV[ RVMNU RWQQM",
    "FgW[WFTFQGOINLLXKZI[H[ RWM]M`NbPcSc\\b_`a]b[b", # /* U+520 LYUDI_CAP MIDDLE_HOOK_CAP */
    "IcV[VMSMQNPPOXNZL[ RVT[T]U^V_X_[^^\\a[b",
    "GhL[LF RLPXP RX[XF RXM^MaNcPdSd\\c_aa^b\\b",
    "HcMTVT RMMM[ RVMV[ RVT[T]U^V_X_[^^\\a[b",
    "F^K[KFYFY[K[",
    "F^K[KFYFY[K[",
    "F^K[KFYFY[K[",
    "F^K[KFYFY[K[",
    "F^K[KFYFY[K[",
    "F^K[KFYFY[K[",
    "F^K[KFYFY[K[",
    "F^K[KFYFY[K[",
    "F^K[KFYFY[K[",
    "F^K[KFYFY[K[",
    "F^K[KFYFY[K[",
    "F^K[KFYFY[K[",
    # /* // Armenian (530-58F) */
    "F^K[KFYFY[K[", # /* U+530 */
    "F^K[KFYFY[K[",
    "F^K[KFYFY[K[",
    "F^K[KFYFY[K[",
    "F^K[KFYFY[K[",
    "F^K[KFYFY[K[",
    "F^K[KFYFY[K[",
    "F^K[KFYFY[K[",
    "F^K[KFYFY[K[",
    "F^K[KFYFY[K[",
    "F^K[KFYFY[K[",
    "F^K[KFYFY[K[",
    "F^K[KFYFY[K[",
    "F^K[KFYFY[K[",
    "F^K[KFYFY[K[",
    "F^K[KFYFY[K[",
    "F^K[KFYFY[K[", # /* U+540 */
    "F^K[KFYFY[K[",
    "F^K[KFYFY[K[",
    "F^K[KFYFY[K[",
    "F^K[KFYFY[K[",
    "F^K[KFYFY[K[",
    "F^K[KFYFY[K[",
    "F^K[KFYFY[K[",
    "F^K[KFYFY[K[",
    "F^K[KFYFY[K[",
    "F^K[KFYFY[K[",
    "F^K[KFYFY[K[",
    "F^K[KFYFY[K[",
    "F^K[KFYFY[K[",
    "F^K[KFYFY[K[",
    "F^K[KFYFY[K[",
    "F^K[KFYFY[K[", # /* U+550 */
    "F^K[KFYFY[K[",
    "F^K[KFYFY[K[",
    "F^K[KFYFY[K[",
    "F^K[KFYFY[K[",
    "F^K[KFYFY[K[",
    "F^K[KFYFY[K[",
    "F^K[KFYFY[K[",
    "F^K[KFYFY[K[",
    "F^K[KFYFY[K[",
    "F^K[KFYFY[K[",
    "F^K[KFYFY[K[",
    "F^K[KFYFY[K[",
    "F^K[KFYFY[K[",
    "F^K[KFYFY[K[",
    "F^K[KFYFY[K[",
    "F^K[KFYFY[K[", # /* U+560 */
    "F^K[KFYFY[K[",
    "F^K[KFYFY[K[",
    "F^K[KFYFY[K[",
    "F^K[KFYFY[K[",
    "F^K[KFYFY[K[",
    "F^K[KFYFY[K[",
    "F^K[KFYFY[K[",
    "F^K[KFYFY[K[",
    "F^K[KFYFY[K[",
    "F^K[KFYFY[K[",
    "F^K[KFYFY[K[",
    "F^K[KFYFY[K[",
    "F^K[KFYFY[K[",
    "F^K[KFYFY[K[",
    "F^K[KFYFY[K[",
    "F^K[KFYFY[K[", # /* U+570 */
    "F^K[KFYFY[K[",
    "F^K[KFYFY[K[",
    "F^K[KFYFY[K[",
    "F^K[KFYFY[K[",
    "F^K[KFYFY[K[",
    "F^K[KFYFY[K[",
    "F^K[KFYFY[K[",
    "F^K[KFYFY[K[",
    "F^K[KFYFY[K[",
    "F^K[KFYFY[K[",
    "F^K[KFYFY[K[",
    "F^K[KFYFY[K[",
    "F^K[KFYFY[K[",
    "F^K[KFYFY[K[",
    "F^K[KFYFY[K[",
    "F^K[KFYFY[K[", # /* U+580 */
    "F^K[KFYFY[K[",
    "F^K[KFYFY[K[",
    "F^K[KFYFY[K[",
    "F^K[KFYFY[K[",
    "F^K[KFYFY[K[",
    "F^K[KFYFY[K[",
    "F^K[KFYFY[K[",
    "F^K[KFYFY[K[",
    "F^K[KFYFY[K[",
    "F^K[KFYFY[K[",
    "F^K[KFYFY[K[",
    "F^K[KFYFY[K[",
    "F^K[KFYFY[K[",
    "F^K[KFYFY[K[",
    "F^K[KFYFY[K[",
    # /* // Hebrew (590-5FF) */
    "F^K[KFYFY[K[", # /* U+590 */
    "F^K[KFYFY[K[",
    "F^K[KFYFY[K[",
    "F^K[KFYFY[K[",
    "F^K[KFYFY[K[",
    "F^K[KFYFY[K[",
    "F^K[KFYFY[K[",
    "F^K[KFYFY[K[",
    "F^K[KFYFY[K[",
    "F^K[KFYFY[K[",
    "F^K[KFYFY[K[",
    "F^K[KFYFY[K[",
    "F^K[KFYFY[K[",
    "F^K[KFYFY[K[",
    "F^K[KFYFY[K[",
    "F^K[KFYFY[K[",
    "F^K[KFYFY[K[", # /* U+5A0 */
    "F^K[KFYFY[K[",
    "F^K[KFYFY[K[",
    "F^K[KFYFY[K[",
    "F^K[KFYFY[K[",
    "F^K[KFYFY[K[",
    "F^K[KFYFY[K[",
    "F^K[KFYFY[K[",
    "F^K[KFYFY[K[",
    "F^K[KFYFY[K[",
    "F^K[KFYFY[K[",
    "F^K[KFYFY[K[",
    "F^K[KFYFY[K[",
    "F^K[KFYFY[K[",
    "F^K[KFYFY[K[",
    "F^K[KFYFY[K[",
    "F^K[KFYFY[K[", # /* U+5B0 */
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
    "F^K[KFYFY[K[",
    "F^K[KFYFY[K[",
    "F^K[KFYFY[K[",
    "F^K[KFYFY[K[",
    "F^K[KFYFY[K[",
    "F^K[KFYFY[K[",
    "F^K[KFYFY[K[",
    "F^K[KFYFY[K[",
    "F^K[KFYFY[K[", # /* U+1220 */
    "F^K[KFYFY[K[",
    "F^K[KFYFY[K[",
    "F^K[KFYFY[K[",
    "F^K[KFYFY[K[",
    "F^K[KFYFY[K[",
    "F^K[KFYFY[K[",
    "F^K[KFYFY[K[",
    "F^K[KFYFY[K[",
    "F^K[KFYFY[K[",
    "F^K[KFYFY[K[",
    "F^K[KFYFY[K[",
    "F^K[KFYFY[K[",
    "F^K[KFYFY[K[",
    "F^K[KFYFY[K[",
    "F^K[KFYFY[K[",
    "F^K[KFYFY[K[", # /* U+1230 */
    "F^K[KFYFY[K[",
    "F^K[KFYFY[K[",
    "F^K[KFYFY[K[",
    "F^K[KFYFY[K[",
    "F^K[KFYFY[K[",
    "F^K[KFYFY[K[",
    "F^K[KFYFY[K[",
    "F^K[KFYFY[K[",
    "F^K[KFYFY[K[",
    "F^K[KFYFY[K[",
    "F^K[KFYFY[K[",
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
