Lzw655/kicad_custom_lib/(notices)

Notices in the files:
scripting/plugins/Kicad_action_plugins-5_99_test/archive_project/archived_test_project/shapes3D/C_1206_3216Metric.step:
Copyright (C) 2017, kicad StepUp
This work is licensed under the [Creative Commons CC-BY-SA 4.0 License](https://creativecommons.org/licenses/by-sa/4.0/legalcode),
with the following exception:
To the extent that the creation of electronic designs that use 'Licensed Material' can be considered to be 'Adapted Material',
You are free to use the library data in your own projects without the obligation to share your project files under this or any other license agreement.
scripting/plugins/InteractiveHtmlBom-master/InteractiveHtmlBom/core/newstroke_font.py:
modify it under the terms of the GNU General Public License
along with this program; if not, you may find one here:
http://www.gnu.org/licenses/old-licenses/gpl-2.0.html
scripting/plugins/Kicad_action_plugins-5_99_test/archive_project/archived_test_project/shapes3D/R_1206_3216Metric.step:
Copyright (C) 2018, kicad StepUp
scripting/plugins/Kicad_action_plugins-5_99_test/archive_project/archived_test_project/shapes3D/PhoenixContact_MSTBA_2,5_2-G-5,08_1x02_P5.08mm_Horizontal.step:
Copyright (C) 2017, Rene Poeschl
scripting/plugins/Kicad_action_plugins-5_99_test/archive_project/archived_test_project/shapes3D/DIP-14_W7.62mm.step:
Copyright (C) 2017, your name
This program is free software: you can redistribute it and/or modify
it under the terms of the GNU General Public License as published by
the Free Software Foundation, either version 3 of the License, or
any later version.
itself might be covered by the GNU General Public License.
scripting/plugins/footprint_wizard/spiralAnt.py:
the Free Software Foundation; either version 2 of the License, or
(at your option) any later version.
